torrematheus/ParahyBaja/Telemetria/telemetria_TesteAV/parahybaja2.jpeg

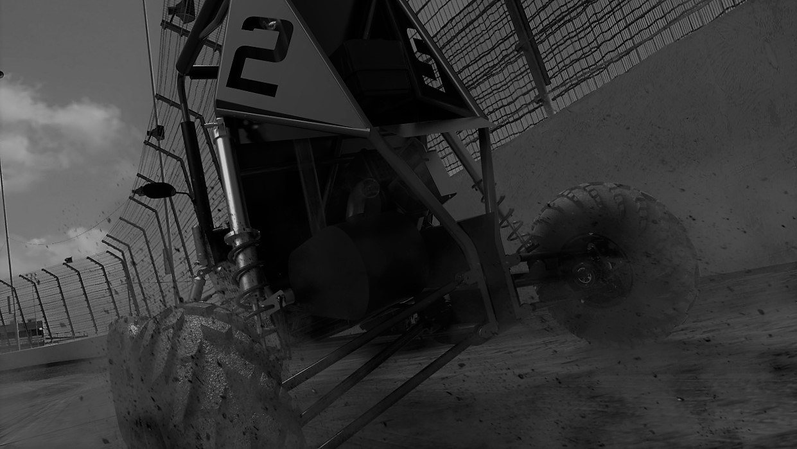
Telemetria/telemetria_TesteAV/parahybaja2.jpeg
