torrematheus/ParahyBaja/README.md

# ParahyBaja
 Hardware, Firmware e Documentação
