torrematheus/ParahyBaja/PB03 - Relatórios/RL01 - TCCs/TCC01 - Matheus Torres Rocha/TCC_Matheus_Torres_Rocha.pdf

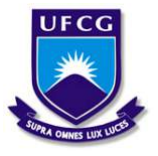
[picture p23: figure]

UNIVERSIDADE FEDERAL DE CAMPINA GRANDE

CENTRO DE ENGENHARIA ELETRICA E ´ | INFORMATICA ´
DEPARTAMENTO DE ENGENHARIA ELETRICA E ´ | INFORMATICA ´

## Sistema de telemetria para veículo off-road baseado em protocolo CAN

Matheus Torres Rocha

Campina Grande, PB

Julho de 2019

Matheus Torres Rocha

## Sistema de telemetria para veículo off-road baseado em protocolo CAN

Trabalho de Conclusao de Curso apresen- ˜

tado a Coordenaç ` | ao do Curso de Graduaç ˜ | aõ

em Engenharia Eletrica da Universidade Fe- ´

deral de Campina Grande, Campus Cam-

pina Grande, como parte dos requisitos ne-

cessarios para a obtenç ´ | ao do grau de Bacha- ˜

rel em Engenharia Eletrica. ´

Area de Concentraç ´ | ao: Instrumentaç ˜ | ao Eletr ˜ | onica, Sistemas Embarcados, Internet das Coisas e Sistemas ˆ
| | | Supervisorios. ´

Orientador: Jose S´ ergio da Rocha Neto ´

Campina Grande, PB

Julho de 2019

Matheus Torres Rocha

## Sistema de telemetria para veículo off-road baseado em protocolo CAN

Aprovado em | / | /

Prof. Jaidilson Jo da Silva ´

Universidade Federal de Campina Grande

Avaliador

Prof. Jose S´ ergio da Rocha Neto ´

Universidade Federal de Campina Grande

Orientador

Aos meus pais que nunca desistiram de mim.

## Agradecimentos

Agradeço primeiramente a Deus por ser o meu porto seguro e me dar forças para continuar cada dia em meio

a tantas dificuldades.

Aos meus pais Dayse e Antonio, ˆ | a minha irm ` | a Thays, ˜ | a minha av ` | o Vanilde, ´ | a minha namorada Klayne, pelo `
suporte e incentivo para eu nunca desistir do meu sonho. Tenho a certeza que nao teria chegado at ˜ | e aqui sem voc ´ | es. ˆ

Ao Prof. Pericles por ser o primeiro professor a acreditar no meu potencial e me dando a oportunidade de ´

estudar tudo que a universidade nao pode me oferecer, ao Prof. Rafael pela amizade, apoio e ajuda e ao amigo Charles ˜

por orientar em diversas situaçoes. Prof. Jos ˜ | e S´ ergio e Prof. Jaidilson por me dar a honra de t ´ | e-los como orientador e ˆ

avaliador, respectivamente, de trabalho de conclusao de curso, direcionando o caminho certo a ser seguido. ˜

A toda equipe ParahyBaja, em especial, Lucas, Douglas e Alberi pela oportunidade de realizar meu projeto `

de conclusao de curso no seu projeto de extens ˜ | ao. ˜

Aos amigos da universidade, em especial, Yago, Junior, Luquinhas e Ravi pela ajuda, incentivo, leites,

brincadeiras e trabalhos desenvolvidos durante todos os anos da minha graduaçao. ˜

Aos meus amigos da epoca do col ´ | egio, em especial, Rennan, Lucas, Giusepe, Gabriel, Maercio, Jorge, ´
Samuel, Emmanuel e Joao por sempre estarem ao meu lado nos momentos mais dif ˜ | | | | | íceis da minha caminhada, me

trazendo felicidade e suporte.

Por fim, agradeço a minha maior fonte de inspiraç ` | ao, minha av ˜ | o, mais conhecida como Dona Isabel a pessoa ´

mais iluminada que tive a honra de conhecer. Que mesmo nao estando presente, fisicamente, tenho certeza que esteve ˜

ao meu lado em todos os momentos da minha vida.

”A unica coisa que ningu ´ | em pode tomar de voc ´ | ê e o ´ conhecimento.”

## Resumo

O nível de tecnologia presente nos carros e um fator determinante quando se trata de conforto, praticidade ´

e desempenho. Assim, a necessidade da presença de telemetria em carros para competiçao Baja SAE ˜

BRASIL e indiscut ´ | ível. Este trabalho de conclusao de curso tem como objetivo o estudo para desenvolver, ˜

elaborar, testar e implementar um sistema de telemetria embarcado utilizando rede de comunicaçao via ˜

protocolo CAN, microcontroladores ST e Computaçao em Nuvem (Cloud Computing) de modo a analisar, ˜

salvar e tratar velocidade, rotaçao por minuto e n ˜ | ível de combustível do carro desenvolvido pela equipe

ParahyBaja.

Palavras chave: CAN, ParahyBaja, SAE BRASIL, Telemetria.

## Abstract

The level of technology present in cars is a determining factor when it comes to comfort, practicality

and performance. As a result, the necessity of telemetry in cars for competition Baja SAE BRAZIL is

unquestionable. The purpose of this paperwork is the study to develop, test and implement an embedded

telemetry system using CAN protocol, ST microcontrollers and Cloud Computing to analyze, save and

treat speed, rotation per minute and fuel level of the car developed by ParahyBaja team.

Keywords: CAN, ParahyBaha, SAE BRASIL, Telemetry.

# Lista de Figuras

1.1 Diagrama dos sensores e componentes para telemetria | | 2
2.1 Diagrama de blocos da conexao gen ˜ | erica de ECU | | 5 ´
2.2 Diagrama com as camadas utilizadas pelo protocolo CAN no modelo OSI | | 6
2.3 Topologia de barramento de rede CAN de acordo com a norma ISO 11898-2 | | 7
2.4 Nível de barramento de acordo com a norma ISO 11898-2 | | 8
2.5 Grafico da taxa de transmiss ´ | ao versus a distancia m ˜ | axima entre os n ´ | os | | 8 ´
2.6 Esquema de uma mensagem de dados | | 9
2.7 Esquema de uma mensagem de erro | | 10
2.8 Exemplo de arbitraçao na rede CAN | | 11 ˜
2.9 Diagrama de blocos de um no CAN | | 11 ´
2.10 Diagrama de blocos de um no CAN com a arquitetura Stand-Alone | | 12 ´
2.11 Diagrama de blocos de um no CAN com a arquitetura Integrada | | 12 ´
2.12 Diagrama de blocos de um no CAN com a arquitetura ´ | Single-Chip | | 13
2.13 Representaçao do funcionamento interno do sensor capacitivo | | 14 ˜
2.14 Exemplificaçao do campo eletromagn ˜ | etico de um sensor capacitivo | | 14 ´
2.15 Representaçao da estrutura interna do sensor indutivo | | 15 ˜
3.1 Representaçao esquem ˜ | atica da vista lateral do Baja ParahyBaja e locais propostos para ECU | | 16 ´

3.2 Circuito implementado na utilizaçao do ˜ | transiver MCP2551 | | 17
3.3 Representaçao esquem ˜ | atica da ECU1 | | 18 ´
3.4 Diagrama geral em maquina de estados da ECU1 | | 18
3.5 Fotografia do sensor indutivo LJ12A3-4-Z/BX | | 19
3.6 Circuito implementado na utilizaçao do sensor indutivo | | 19 ˜
3.7 Fotografia da bobina acoplada ao eixo do motor | | 20
3.8 Curvas da saída do sensor de rpm puro (2) e saída do sensor de rpm tratado (1) | | 21
3.9 Circuito implementado na utilizaçao do sensor de RPM | | 21 ˜
3.10 Fotografia do sensor capacitivo LJC18A3-B-Z/BY | | 22
3.11 Circuito implementado na utilizaçao do sensor de combust ˜ | ível | | 23
3.12 Representaçao esquem ˜ | atica da ECU2 | | 24 ´
3.13 Diagrama geral em maquina de estados da ECU2 | | 24
3.14 Representaçao esquem ˜ | atica da ECU3 | | 25 ´
3.15 Exemplo do painel frontal com LCD | | 25
3.16 Diagrama do recebimento de dados WEB | | 26
3.17 Escopo da mensagem JSON dentro do MongoDB | | 27
3.18 Fotografia do cabeçalho de dados unicos na plataforma ´ | WEB | | 28
3.19 Graficos de rpm em funç ´ | ao do tempo na plataforma ˜ | WEB | | 28
3.20 Graficos de velocidade em funç ´ | ao do tempo na plataforma ˜ | WEB | | 29
4.1 Fotografia do sistema implementado em protoboard | | 31
4.2 Fotografia da montagem do motor e sensores em bancada | | 32
4.3 Circuito simulador de RPM | | 33
4.4 Fotografia da placa final ECU1 | | 34

4.5 Fotografia das placas finais ECU3 e ECU2 | | 34
4.6 Fotografia do painel e sensores localizados no Baja | | 35
4.7 Plataforma WEB | | 36

# Lista de Abreviaturas e Siglas

CAN | - Controller Area Network
CI | - Circuito Integrado
ECU | - Electronic Controller Unit
GND | - Ground
GPS | - Global Position System
I2C | - Inter-Integrated Circuit
RPM | - Rotaçoes por Minuto ˜
SAE | - Sociedade de Engenheiros da Mobilidade

# Conteudo ´

1 Introduçaõ | 1
1.2 Organizaçao do texto | | 3 ˜
2 Revisao Bibliogr ˜ | afica ´ | 4
2.2 Competiçao Baja SAE BRASIL | | 5 ˜
2.3 Protocolo de Comunicaçao CAN | | 6 ˜
2.3.4 | No CAN | | 11 ´
3 Sistema Implementado | 16

3.4 Interface Humano-Maquina | | 26 ´
4 Implementaçaõ | 30
4.1 Implementaçao em Bancada | | 30 ˜
4.2 Confecçao das Placas | | 33 ˜
4.3 Implementaçao no Baja | | 34 ˜
5 Conclusoes ˜ | 37
6 Bibliografia | 38

# Capítulo 1

# Introduçaõ

No decorrer dos avanços tecnologicos, a eletr ´ | onica automotiva vem se tornando cada vez mais presente ˆ

no dia a dia dos indivíduos, tornando-se essencial para o conforto e a segurança do condutor, assim como para o

funcionamento e a performance de veículos.

Ao logo do desenvolvimento tecnologico dispositivos (sensores e atuadores) foram desenvolvidos para au- ´

xiliar na automaçao de m ˜ | aquinas, equipamentos e processos. Os sensores, mais especificamente, tem um papel in- ´
contestavel para o desenvolvimento automotivo. Possibilitando a verificaç ´ | ao e obtenç ˜ | ao de dados para processos, at ˜ | é
entao, indetect ˜ | aveis, como por exemplo velocidade, rotaç ´ | ao por minuto, entre outros [3]. ˜
Dada a importancia da eletr ˆ | onica automotiva, microcontroladores s ˆ | ao projetados e programados para serem ˜
embarcados em linhas automotivas chamados de unidade de controle eletronico ( ˆ | Electronic Control Unit - ECU). Suas
aplicaçoes s ˜ | ao as mais diversas poss ˜ | íveis, possuindo uma capacidade de processamento.

Exitem diversas ECU distribuídas pelo carro, por exemplo, no controle de nível de combustível por meio de

sensores resistivos, no controle de acionamento de airbag atraves de sensores de vibraç ´ | ao e no veloc ˜ | ímetro atraves de ´

sensores indutivos.

Entre as ECU tem-se entao a necessidade de uma comunicaç ˜ | ao precisa e segura, de forma a garantir con- ˜

fiabilidade e qualidade do sistema. Para essa necessidade, o sistema de barramento de dados CAN e utilizado como ´

padrao para a aplicaç ˜ | ao veicular [4 - 5], estando presente em todos os carros desenvolvidos atualmente. ˜

Entretanto, os veículos off-road Baja, mais precisamente os veículos utilizados para competiçao Baja SAE ˜

BRASIL, possuem uma deficiencia quando se trata de eletr ˆ | onica digital automotiva por se tratar de carros que necessi- ˆ
tam, a princípio, apenas de botoes de emerg ˜ | encia e luzes para seu funcionamento. ˆ
Em uma competiçao com foco em desenvolvimento tecnol ˜ | ogico, a implementaç ´ | ao de ECU se torna ne- ˜

cessaria, a fim de validar diversas funcionalidade do sistema, alcançar objetivos, conforto do piloto e melhorar perfor- ´

mance do veículo, tornando-se necessaria a criaç ´ | ao de um sistema de telemetria. ˜
Telemetria consiste na aquisiçao e envio de dados para um acumulador visando uma posterior an ˜ | alise [3]. ´
Possibilitando uma possível verificaçao de dados remotamente, por exemplo em pain ˜ | eis automotivos, ou nos dias atuais ´

a verificaçaõ online em meio a rede de internet.

## 1.1 Objetivo

Neste trabalho de conclusao de curso tem-se como objetivo projetar um sistema de eletr ˜ | onica embarcada ˆ
responsavel pela aquisiç ´ | ao, transmiss ˜ | ao e exibiç ˜ | ao de dados relevantes para a equipe e para o piloto em tempo real, ˜
tais como: rotaçao do motor, n ˜ | ível de combustível e velocidade. Uma possível soluçao do sistema est ˜ | a apresentada na ´

Figura 1.1:

Figura 1.1: Diagrama dos sensores e componentes para telemetria.

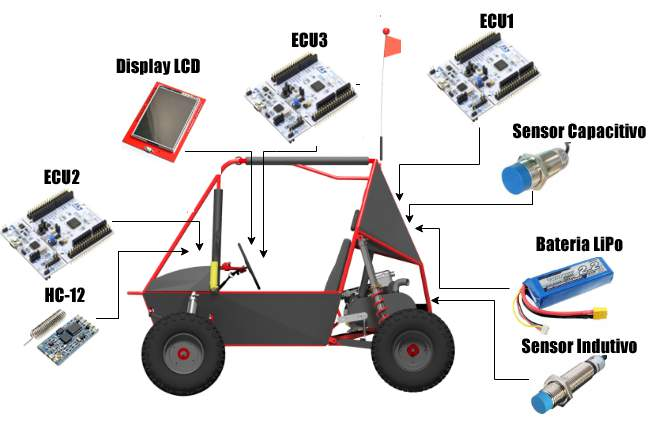
[picture p24: figure]

Fonte: Proprio Autor. ´

A alocaçao de sensores, seguida da aquisiç ˜ | ao dos dados para as ECU respons ˜ | aveis pela comunicaç ´ | ao com o ˜

painel e com o computador central, sera deste modo, um sistema de telemetria para o carro da equipe ParahyBaja. Os ´

objetivos específicos sao: ˜

- Selecionar tipos de sensores e ECU para aplicaçoes; ˜
- Desenvolver circuitos equivalentes para as aplicaçoes; ˜

- Desenvolver a programaçao do sistema; ˜
- Executar montagem do sistema em placa de ensaio;
- Planejar e executar testes para validaçao do sistema desenvolvido; ˜
- Desenvolver modulos definitivos para o projeto; ´
- Executar testes e implementaçao do sistema desenvolvido no ve ˜ | ículo.

## 1.2 Organizaçao do texto ˜

Neste capitulo foi apresentado a introduçao e os meus objetivos para esse trabalho de conclus ˜ | ao de curso. No ˜
capítulo 2 sera apresentada uma abordagem te ´ | orica aos t ´ | opicos relevantes do trabalho, para uma melhor compreens ´ | aõ

das atividades desenvolvidas. No capítulo 3, o sistema implementado. No capítulo 4, implementaçoes realizadas. Por ˜

fim, no capitulo 5 sao analisados os resultados com propostas para estudos futuros. ˜

# Capítulo 2

Revisao Bibliogr ˜ | afica ´

Neste capítulo apresenta-se os principais conceitos e fundamentos envolvidos no sistema proposto. Saõ

aqui descritos os conceitos de telemetria, competiçao Baja SAE BRASIL, protocolo de comunicaç ˜ | ao CAN e sensores ˜

utilizados.

## 2.1 Telemetria

A telemetria surgiu no ano de 1845 com o desenvolvimento do primeiro sistema de transmissao de dados ˜

entre o Winter Palace e o quartel da armada russa [3]. Em 1874 foi desenvolvida uma rede de sensores atmosfericos ´

em Mont Blanc, França, com transmissao de dados em tempo real para Paris. Mais tarde, em 1906 foram montadas ˜

series de estaç ´ | oes s ˜ | ísmicas na Russia, com transmiss ´ | ao de dados para o Pulkovo Observatory [3]. ˜
A telemetria automotiva e amplamente utilizada em ve ´ | ículos de uso comercial e maquinas agr ´ | ícolas [3].
O sistema de telemetria automotiva e respons ´ | avel pelo transporte e pelo armazenamento de dados do carro, como a ´
velocidade, a rotaçao do motor, o n ˜ | ível de combustível, a temperatura do motor, etc. Essa aquisiçao de dados ˜ | e realizada ´

por meio de sensores interligados, dos mais diversos tipos e maneiras.

A arquitetura interna do hardware composto nos veículos automotivos e distribu ´ | ída em ECU responsaveis, ´
em grande maioria, por uma aquisiçao de dados direcionado a um ˜ | unico sensor, atuador ou aç ´ | ao do ve ˜ | ículo. Seu nível

de complexidade e seu numero de ECU, disponíveis e conectadas entre si, e diretamente proporcional ao valor do ´

veículo [1].

As ECUs sao conectadas entre si atrav ˜ | es de um ´ | unico barramento para troca de informaç ´ | oes e concatenaç ˜ | aõ
do sistema como um todo. Assim, a diminuiçao do n ˜ | umero de cabos necess ´ | arios para conex ´ | ao das mesmas, maior ˜

robustez levando em consideraçao que erros em uma ECU podem n ˜ | ao afetar outras, podem ser observados como ˜
pontos positivos para a implementaç ` | ao de ECU, em contrapartida o custo, a exig ˜ | encia de uma implementaç ˆ | ao de ˜
protocolo de comunicaçao entre ECU s ˜ | ao pontos negativos do seu desenvolvimento. Um exemplo de conex ˜ | ao entre ˜

ECU e apresentada na Figura 2.1 ´

Figura 2.1: Diagrama de blocos da conexao gen ˜ erica de ECU. ´

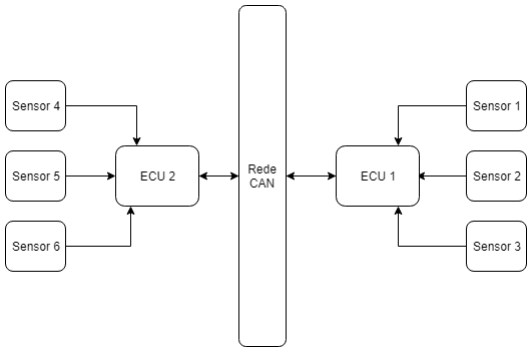
[picture p25: figure]

Fonte: Proprio Autor. ´

Diante dos avanços tecnologicos os bancos de dados, os tratamento de dados e as amostragem de resultados ´

estao sendo cada vez mais direcionado a sistemas em nuvem. Estes podendo ser acessados de qualquer parte do mundo, ˜

possuindo como pre-requisito apenas o acesso a internet. ´

## 2.2 Competiçao Baja SAE BRASIL ˜

O programa Baja SAE foi criado na Universidade da Carolina do Sul, Estados Unidos, sob a direçao do ˜

Dr. John F. Stevens, tendo sua primeira ediçao em 1976. O ano de 1991 marcou o in ˜ | | ício das atividades da SAE

BRASIL, que, em 1994, lançava o Programa Baja SAE BRASIL. No ano seguinte, em 1995, seria realizada a primeira

competiçao nacional, na pista Guido Caloi, bairro do Ibirapuera, cidade de S ˜ | | ao Paulo [10]. ˜

A competiçao SAE Baja Brasil tem por objetivo de conectar estudantes de diversas universidades para dis- ˜

putar uma competiçao que tem o intuito de projetar, desenvolver e criar carros tipo baja, capazes de superar diversas ˜

condiçoes, como por exemplo, lama, chuva, trepidaç ˜ | ao, etc. O ve ˜ | ículo deve ser capaz de acomodar um condutor desde

1,45 m de altura, com peso de 42 kg ate um condutor de 1,90 m de altura, com peso de 109 kg [10]. ´

## 2.3 Protocolo de Comunicaçao CAN ˜

Decorrente do alto numero de dispositivos de controles, sensores e atuadores presentes nos automoveis, ´

o numero de cabos para conexoes tornou-se um grande problema para a manutenç ˜ | ao, criaç ˜ | ao e detecç ˜ | ao de falhas ˜
muito complexas nos automoveis. Por essa raz ´ | ao, o protocolo de comunicaç ˜ | ao CAN ( ˜ | Controller Area Network) foi

desenvolvido pela empresa Robert Bosch GmbH na decada de 80 [5]. ´

Esse protocolo e definido pela resoluç ´ | ao ISO 11898 e tr ˜ | as consigo um modelo de referencia tipo OSI ( ´ | Open
System Interconnection), possuindo tres camadas: a camada f ˆ | ísica, a camada de enlace de dados e a camada de
aplicaçao. A camada de aplicaç ˜ | ao pode ser desenvolvida a crit ˜ | erio do desenvolvedor como por exemplo, o ´ | CANo-

pen [4]. Na Figura 2.2 apresenta-se as camadas que sao utilizadas dentro do modelo OSI pelo protocolo CAN. ˜

Figura 2.2: Diagrama com as camadas utilizadas pelo protocolo CAN no modelo OSI.

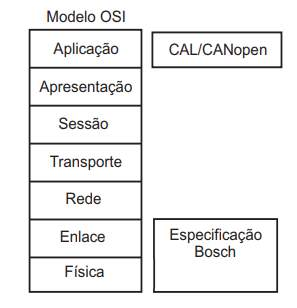
[picture p26: figure]

Fonte: Adaptado de [6].

Sua camada de enlace e física nao podem ser modificadas e s ˜ | ao diretamente implementadas no microchip de ˜
controle, ja a camada de aplicaç ´ | ao, como elencado anteriormente, fica a crit ˜ | erio do desenvolvedor. ´
O protocolo CAN tem como principais vantagens: a robustez, a reduçao de ru ˜ | ídos eletromagneticos e a ´
diminuiçao da complexidade de conex ˜ | oes entre sensores e atuadores [7]. Tamb ˜ | em, a sua especificaç ´ | aõ e dividida ´
em dois padroes para a vers ˜ | ao CAN 2.0, identificadas como 2.0A e 2.0B, possuindo diferença entre o tamanho do ˜
identificador de mensagem com 11 bits e 29 bits respectivamente. Entretanto, os dois padroes s ˜ | ao compat ˜ | íveis entre si

[4].

### 2.3.1 Camada Física

A transmissao de dados do protocolo CAN, ˜ | e composto por um par de fios trançados possuindo uma re- ´
sistencia de 120 Ohms nas pontas do seu barramento a fim de evitar reflex ˆ | oes do sinal e minimizar os efeitos eletro- ˜

magneticos. Pode-se observar a topologia de barramento da rede CAN na Figura 2.3. ´

Figura 2.3: Topologia de barramento de rede CAN de acordo com a norma ISO 11898-2.

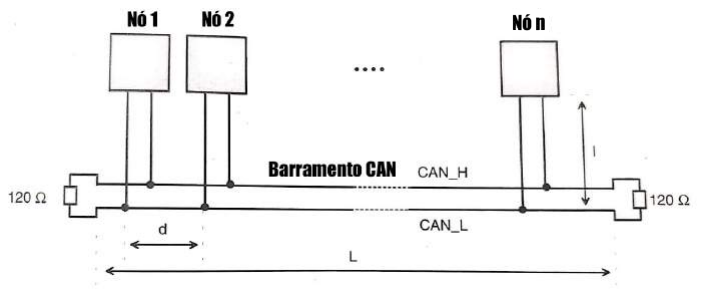
[picture p27: figure]

Fonte: Adaptado de [5].

Composto por dois fios, CAN H (CAN HIGH) e CAN L (CAN LOW), possui seu nível logico medido ´

decorrente da diferença de potencial entre os fios.

Vdif = VCAN H − VCAN L | (2.1)
Assim, quando seu nível logico possui um valor ´ | Vdif < 0, 5 e considerado recessivo e consequentemente ´
um valor 0, quando Vdif > 0, 9 e considerado dominante e possu ´ | í valor 1. O grafico da relaç ´ | ao entre a diferença de ˜

potencial dos fios pode ser vista na Figura 2.4

Figura 2.4: Nível de barramento de acordo com a norma ISO 11898-2.

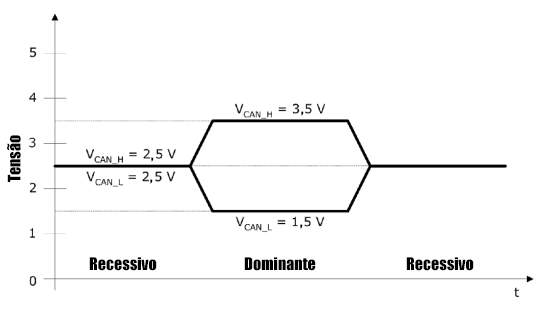
[picture p28: figure]

Fonte: Adaptado de [5].

A rede CAN apresenta limitaçoes para seu funcionamento, possuindo uma relaç ˜ | ao m ˜ | axima entre a taxa de ´
transferencia de bits versus a distancia m ˆ | axima permitida para o seu funcionamento (Figura 2.5). ´
Figura 2.5: Grafico da taxa de transmiss ´ | ao versus a distancia m ˜ | axima entre os n ´ | os. ´

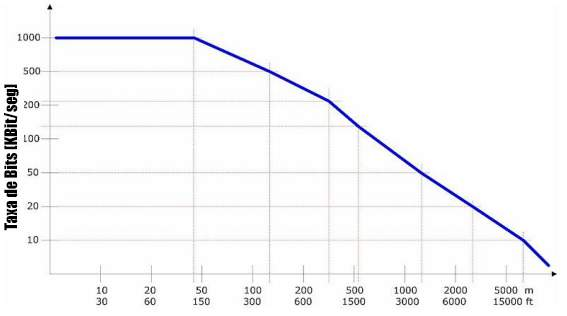
[picture p29: figure]

Fonte: Adaptado de [5].

### 2.3.2 Camada de Enlace

Os dados transmitidos atraves da rede CAN possuem quatro tipos distintos de mensagem: ´

Mensagem de Dados

A estrutura da mensagem de dados, apresentada na Figura 2.6, possui espaços especificamente alocados para

determinado dado da mensagem, sao eles: SOF ( ˜ | Start of Frame), arbitraçao ( ˜ | Arbitration Field), controle (Control

Field), campo de dados (Data Field), CRC (Cyclic Redundancy Check), ACK (Acknowledgement) e EOF (End of

Frame) [6].

Figura 2.6: Esquema de uma mensagem de dados.

Fonte: [6].

SOF - Responsavel por marcar o inicio da mensagem, apresentado por um ´ | unico bit dominante. ´
Arbitraçaõ - O campo de arbitraçao possui dois tamanhos, 11 ˜ | bits para a versao 2.0 A e 29 ˜ | bits para versao 2.0 ˜
B, ele e respons ´ | avel por enviar o n ´ | ível de prioridade da mensagem, seguindo a regra que quando menor for o
valor maior e o seu n ´ | ível de prioridade. Tambem, envia em seu ´ | ultimo bit ( ´ | Remote Transmit Request - RTR) a
responsabilidade de afirmar sua requisiçao de retransmiss ˜ | ao de dados. ˜
Controle - Seu primeiro bit (IDE) e respons ´ | avel por identificar a vers ´ | ao da rede CAN e, em seus ˜ | bits restantes, possui

a tarefa de informar a quantidade de bytes que serao transmitidas na mensagem. ˜

Campo de dados - Reservado para transmissao da mensagem, possuindo um tamanho m ˜ | aximo de 8 ´ | bytes.
CRC - Responsavel por conter o ´ | checksum da mensagem para uma verificaçao de poss ˜ | íveis erros na transmissao de ˜

dados.

ACK - E respons ´ | avel por reconhecer uma mensagem sem erro, o transmissor verifica atrav ´ | es da resposta do receptor, ´
caso essa resposta esteja correta e enviada bit dominante e caso contrario ´ | e enviado um bit recessivo. ´

EOF - Responsavel por finalizar a mensagem. ´

Mensagem de requisiçao remota de dados ˜

Utilizado para solicitar dados, a estrutura da mensagem de requisiçao remota de dados possui os mesmos ˜

campos da mensagem de dados, entretanto nao possui o campo de dados. ˜

Mensagem de erro

A estrutura da mensagem de erro pode ser verificada na Figura 2.7.

Figura 2.7: Esquema de uma mensagem de erro.

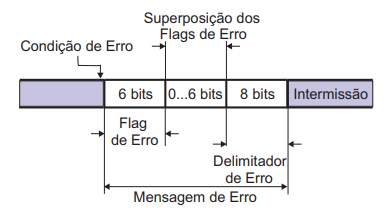
[picture p30: figure]

Fonte: [6].

Os primeiros 6 bits da mensagem correspondem à flag de erro que possui dois estados: o ativo, que identifica

erro em nos ativos e o passivo, que identifica erro em n ´ | os passivos. O delimitador de ´ | flags de erro e composto por oito ´

bits recessivos.

Mensagem de sobrecarga

A mensagem de sobrecarga e igual ´ | a estrutura utilizada para a mensagem de erro, mas ` | e utilizada para realizar ´

atrasos maiores na transmissao de pacotes. ˜

### 2.3.3 Controle de Acesso ao Meio

Para controlar o acesso ao meio a CAN utiliza o metodo CSMA/CA ( ´ | Carrier-Sense Multiple Acess with
Collision Avoidance), o metodo garante que durante a fase de arbitraç ´ | ao, ou seja, durante a disputa pelo acesso ao ˜
barramento, apenas o no que tiver a mensagem com maior prioridade permanecer ´ | a transmitindo a mensagem ap ´ | os o ´

final do campo de arbitraçao [4]. ˜

O metodo funciona da seguinte maneira: quando o n ´ | o envia o ´ | bit dominante, ele continua no processo, e
envia o proximo ´ | bit da sua mensagem de arbitraçao, caso um n ˜ | o envie um ´ | bit recessivo enquanto outro no envia o ´ | bit

dominante esse no ganhar ´ | a a disputa para leitura de dados. Por exemplo, pode ser observado no bit 5 (N ´ | o 2) e no bit 2 ´
(No 1) do identificador, na Figura 2.8, vencendo o n ´ | o 3, visto que ele cont ´ | em a mensagem com maior prioridade [6]. ´

Figura 2.8: Exemplo de arbitraçao na rede CAN. ˜

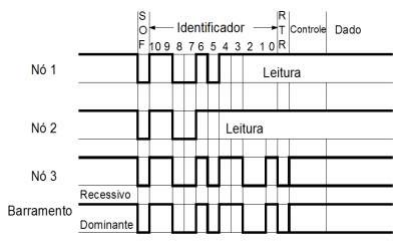
[picture p31: figure]

Fonte: [6].

### 2.3.4 No CAN ´

Para implementar um no CAN (Figura 2.9) s ´ | ao necess ˜ | arios tr ´ | es componentes b ˆ | asicos: um ´ | transceiver, um

controlador CAN e um microcontrolador [6]. Cada componente possui uma açao primordial para o funcionamento ˜

da rede CAN, o microcontrolador e respons ´ | avel por configurar os perif ´ | ericos (sensores e atuadores) instalados em ´
seu sistema, o controlador CAN e respons ´ | avel por disponibilizar as funç ´ | oes para uma poss ˜ | ível implementaçao e o ˜
transceiver e respons ´ | avel por traduzir os dados que chegam atrav ´ | es do barramento CAN. ´

Figura 2.9: Diagrama de blocos de um no CAN. ´

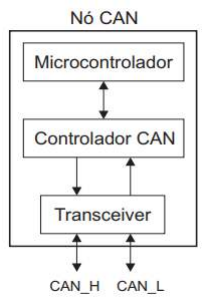
[picture p32: figure]

Fonte: [6].

Existem diversos tipos de microcontroladores no mercado, ao que se trata de protocolo CAN, eles podem ser

classificados em tres tipos de microcontroladores [7]: ˆ

- Stand-Alone
Na arquitetura Stand-Alone (Figura 2.10) e separada do controlador CAN e do ´ | transceiver, necessitando acoplar

um controlador e um transceiver em sua implementaçao. ˜

Figura 2.10: Diagrama de blocos de um no CAN com a arquitetura Stand-Alone. ´

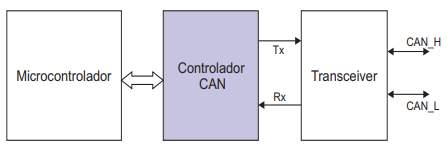
[picture p33: figure]

Fonte: [6].

- Integrada;

Na arquitetura integrada (Figura 2.11) temos o microcontrolador e o controlador integrados em um unico chip e ´

apenas o transceiver separado da implementaçao. ˜

Figura 2.11: Diagrama de blocos de um no CAN com a arquitetura Integrada. ´


Fonte: [6].

- Single-Chip;

Na arquitetura Single-Chip (Figura 2.12) temos o microcontrolador, controlador e transceiver unidos em um

unico chip. ´

Figura 2.12: Diagrama de blocos de um no CAN com a arquitetura ´ | Single-Chip.

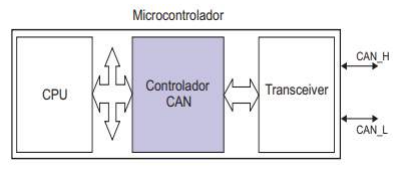
[picture p34: figure]

Fonte: [6].

## 2.4 Sensores

Existem diversos tipos de sensores, como por exemplo os sensores capacitivos e os sensores indutivos.

### 2.4.1 Sensor Capacitivo

O sensor capacitivo (Figura 2.13) em seu princípio operacional toma como parametro a capacit ˆ | ancia. Uma ˆ

chave de proximidade capacitiva funciona com um circuito oscilante de alta frequencia que cria um campo eletro- ˆ

magnetico na superf ´ | ície ativa do sensor por meio de um capacitor. Quando uma substancia solida ou fluida se apro- ´
xima deste campo ocorre um desequilíbrio de capacitancia e leva a uma variaç ˆ | ao da amplificaç ˜ | ao no circuito oscilante. ˜
Se esta amplificaçao exceder um valor limite, um sinal de comutaç ˜ | aõ e gerado. Uma exemplificaç ´ | ao de suas ondas ˜

eletromagneticas podem ser vistas na Figura 2.14 [8]. ´

Figura 2.13: Representaçao do funcionamento interno do sensor capacitivo. ˜

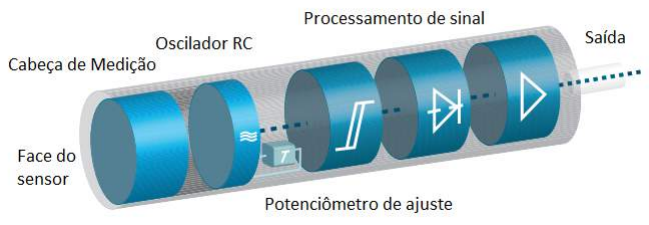
[picture p35: figure]

Fonte: Adaptado de [8].

Figura 2.14: Exemplificaçao do campo eletromagn ˜ | etico de um sensor capacitivo. ´

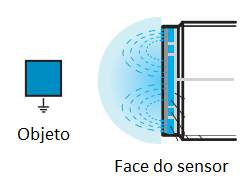
[picture p36: figure]

Fonte: Adaptado de [8].

O sensor pode ser pre-fabricado em diversas situaç ´ | ao de funcionamento, l ˜ | ogica positiva (PNP) ou l ´ | ogica ´
negativa (NPN), ou seja, no caso PNP, o sensor indicara um n ´ | ível logico alto ao detectar uma variaç ´ | ao no seu campo, ˜
ja no caso NPN, o sensor indicar ´ | a um n ´ | ível logico baixo para as mesmas condiç ´ | oes. ˜

### 2.4.2 Sensor Indutivo

Assim como o sensor capacitivo, o funcionamento do sensor indutivo (Figura 2.15) em seu princípio opera-

cional toma como parametro a indut ˆ | ancia. ˆ
Seu funcionamento consiste em um íma de barra, com um pino ferromagn ˜ | etico, sustentando uma bobina de ´

induçao com dois terminais e quando uma engrenagem de anel ferromagn ˜ | etico (ou um rotor de projeto semelhante) ´
passa por este sensor, gera uma tensao na bobina, tens ˜ | ao esta diretamente proporcional a variaç ˜ | ao peri ˜ | odica do fluxo ´

magnetico [9]. ´

Esse tipo de sensor, possui o mesmo funcionamento de logica do sensor capacitivo, ou seja, ele pode ser ´

fabricado como PNP ou como NPN.

Figura 2.15: Representaçao da estrutura interna do sensor indutivo. ˜

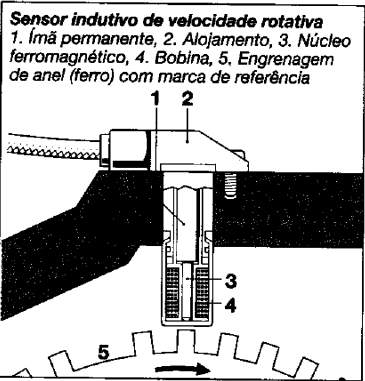
[picture p37: figure]

Fonte: [9].

# Capítulo 3

# Sistema Implementado

Primeiramente, foi feito um estudo sobre sistemas em veículos automotivos, baseado em carros confecciona-

dos por grandes empresas, optou-se por um sistema em rede CAN, contendo tres ECU interligadas entre si, possuindo ˆ

tres tipos de sensores: sensor de velocidade, sensor de rotaç ˆ | oes por minuto e sensor de combust ˜ | ível. Tambem, o sistema ´

(Figura 3.1) possui o diferencial de estar diretamente interligado ao um sistema online e um banco de dados.

Figura 3.1: Representaçao esquem ˜ | atica da vista lateral do Baja ParahyBaja e locais propostos para ECU. ´

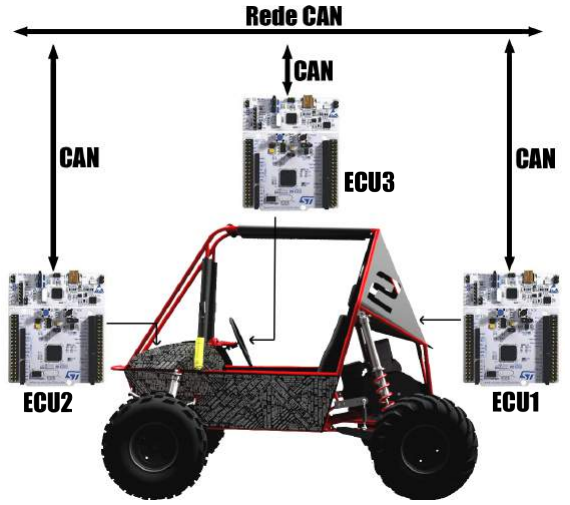
[picture p38: figure]

Fonte: Proprio Autor. ´

As ECUs utilizadas tem como base o microcontrolador NUCLEO-F303RE, fabricado pela empresa STMicro-

electronics responsavel, tamb ´ | em, por fabricar sistemas para utilizaç ´ | ao em ve ˜ | ículos automotivos por grande empresas

como: BMW, Mecedes, etc. Entretanto, o microcontrolador utilizado para esse projeto, trata-se de um microcontrola-

dor com arquitetura integrada, necessitando, assim, de um transiver.

O transiver utilizado e o MCP2551, segundo MCP2551 foi montado o circuito (Figura 3.2). ´

Figura 3.2: Circuito implementado na utilizaçao do ˜ transiver MCP2551.

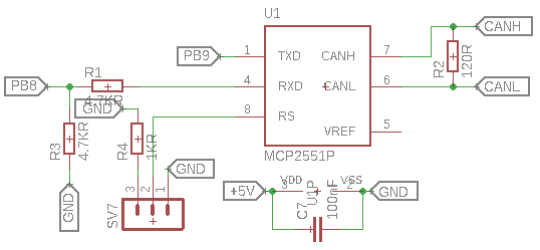
[picture p39: figure]

Fonte: Proprio Autor. ´

Pode-se verificar que o circuito trata as mensagens CAN H e CAN L com o objetivo de enviar dados atraves´

de seu RX e TX para o controlador interligados com os pinos PB8 e PB9, respectivamente, do microcontrolador.

## 3.1 ECU1

A ECU1 (Figura 3.3), e respons ´ | avel por obter e trata as informaç ´ | oes dos sensores implementados no carro e ˜

repassar essas informaçoes ao longo do barramento CAN. ˜

Figura 3.3: Representaçao esquem ˜ | atica da ECU1. ´

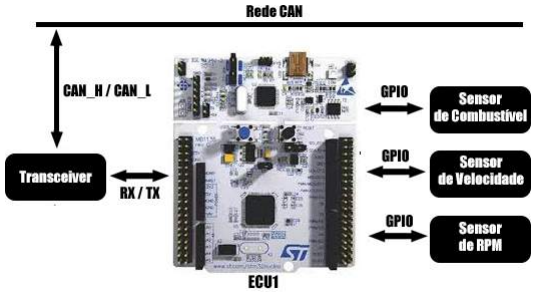
[picture p40: figure]

Fonte: Proprio Autor. ´

Ao ser chamada a interrupçao temporal implementada no microcontrolador, toda a informaç ˜ | ao adquirida dos ˜
sensores sao tratadas em inteiros de oito ˜ | bits e enviada. O funcionamento geral da ECU1 pode ser vista decorrente do

diagrama em maquina de estados da Figura 3.4.

Figura 3.4: Diagrama geral em maquina de estados da ECU1.

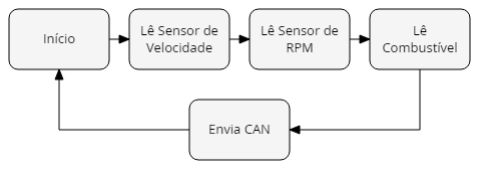
[picture p41: figure]

Fonte: Proprio Autor. ´

### 3.1.1 Sensor de Velocidade

Para o sensor de velocidade, utilizou-se o sensor indutivo (Figura 3.5 - LJ12A3-4-Z/BX) decorrente de seu

baixo custo de mercado, da sua precisao e do seu grau de proteç ˜ | ao ser IP65. Segundo ETT, o sensor possui polaridade ˜
NPN, com um nível de tensao de operaç ˜ | ao entre 6 e 36 volts em tens ˜ | ao continua e uma corrente de sa ˜ | ída de 300 mA

[12].

Figura 3.5: Fotografia do sensor indutivo LJ12A3-4-Z/BX.

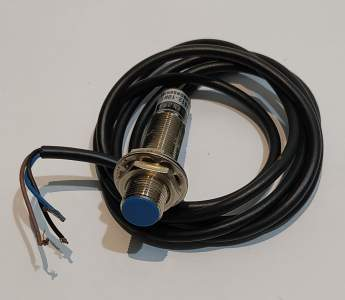
[picture p42: figure]

Fonte: Proprio Autor. ´

Esse sinal eletrico ´ | e recebido e tratado utilizando um circuito eletr ´ | onico (Figura 3.6). ˆ

Figura 3.6: Circuito implementado na utilizaçao do sensor indutivo. ˜


Fonte: Proprio Autor. ´

Onde a entrada VEL e respons ´ | avel por receber o sinal puro do sensor indutivo e o pino PA10 ´ | e respons ´ | avel ´

por enviar o sinal tratado para o microcontrolador. O circuito referente ao tratamento de dados do sensor de velocidade

e composto por um amplificador operacional implementado com a funç ´ | ao de ˜ | buffer com o intuito de isolar o sensor
[11]. Tambem, alimentando o mesmo com uma tens ´ | ao de +3,3 V e terra ˜ | e poss ´ | ível regular a seu nível logico para 3,3 ´
V, o nível logico m ´ | aximo exigido pelo microcontrolador. ´
O sensor e posicionado bem pr ´ | oximo ao eixo de rotaç ´ | ao do carro, similar a Figura 2.15, ao longo do eixo s ˜ | aõ
anexados quatro ímas igualmente espaçados a fim de aumentar a precis ˜ | ao do sensor. ˜

Em seu algoritmo de implementaçao, ˜ | a cada volta do pneu o microcontrolador receber ` | a quatro pulsos em ´
sua entrada digital, entrada na qual esta programada com uma interrupç ´ | ao externa, incrementando valor unit ˜ | ario a um ´
contador especifico. Ao longo de um período de tempo, ja pr ´ | e-determinado, esse contador ´ | e verificado se seu valor ´
e divis ´ | ível por quatro, caso nao seja, recebe um decremento at ˜ | e ser divis ´ | ível por quatro e, entao, ˜ | e utilizado para o ´

calculo da velocidade. Logo em seguida, o contador zerado, retomando, assim, o fluxo de contagem. ´

O veículo automotivo possui uma velocidade variada ao longo de sua trajetoria, variado sua aceleraç ´ | ao. ˜
Entretanto, utilizando-se da equaçao do movimento retil ˜ | íneo uniformemente variado (MRUV), sabendo-se que a
interrupçao temporal ˜ | e muito r ´ | apida e a aceleraç ´ | ao no intervalo de tempo para o motor do carro ˜ | e irris ´ | oria, pode- ´

mos considerar seu movimento como um movimento retilíneo e uniforme (MRU) no pequeno intervalo de tempo e

aplicar a equaçao MRU a fim de se obter a velocidade [11]. ˜

Vm = 3, 6

Pv
Pe
Tv
Cp | (3.1)
Em sua equaçao, ˜ | a velocidade ( ` | Vm), primeiramente, e calculada com o contador referente a interrupç ´ | aõ
digital do sensor de velocidade (Pv) dividido pela quantidade de ímas no eixo ( ˜ | Pe), posteriormente o resultado é
dividido por o tempo da interrupçao temporal em segundos ( ˜ | Tv), multiplicado por comprimento do pneu (Cp) e,

finalmente, multiplicado por 3,6 para transformar de metros por segundo em quilometros por hora. ˆ

### 3.1.2 Sensor de RPM

O sensor de RPM utilizado ao sistema, trata-se de uma bobina acoplada ao eixo interno do motor (Figura

3.7).

Figura 3.7: Fotografia da bobina acoplada ao eixo do motor.

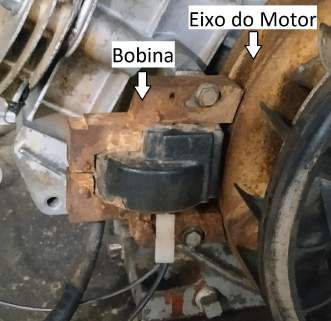
[picture p43: figure]

Fonte: Proprio Autor. ´

O eixo possui um íma em seu eixo, ao passar pr ˜ | oximo a bobina, gera um campo eletromagn ´ | etico fazendo a ´
bobina conduzir eletricidade e projeta um espectro (Figura 3.8) cujo a frequ ` | encia ˆ | e modificada ao depender, especifi- ´

camente, da velocidade do eixo, ou seja, velocidade do motor.

Figura 3.8: Curvas da saída do sensor de rpm puro (2) e saída do sensor de rpm tratado (1).

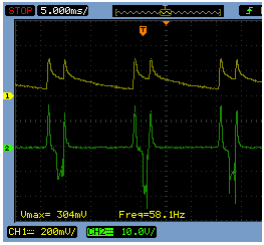
[picture p44: figure]

Fonte: Proprio Autor. ´

A curva e tratado atrav ´ | es de um circuito el ´ | etrico (Figura 3.9) para tratar o sinal para uma leitura adequada do ´

microcontrolador.

Figura 3.9: Circuito implementado na utilizaçao do sensor de RPM. ˜

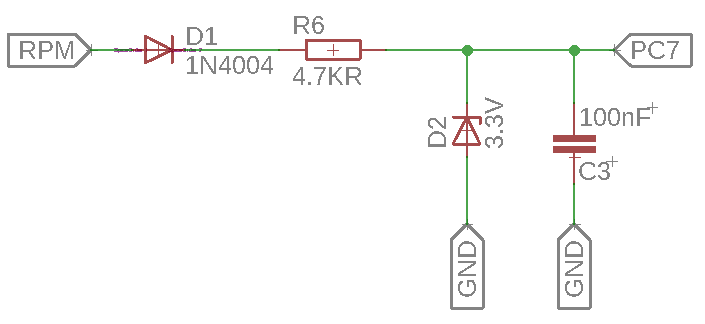
[picture p45: figure]

Fonte: Proprio Autor. ´

Primeiramente, seu sinal e retificado atrav ´ | es do diodo (D1), logo ap ´ | os´ e regulado a tens ´ | ao a um n ˜ | ível de
aproximadamente 3,3 V decorrente do diodo zener (D2). Tambem, para evitar ru ´ | ídos, foi-se necessario implementar ´

um capacitor (C3).

O seu algoritmo, funciona com interrupçao externa da variaç ˜ | ao de mudança do seu n ˜ | ível logico para uma ´

possível decida e subida, como visto na Figura 3.8, tera quatro pulsos para cada volta do eixo do motor mudando ´

apenas a sua equaçao e a cada interrupç ˜ | ao um contador ˜ | e incrementado. Ap ´ | os isso, o RPM ´ | e calculado, por meio da ´
equaçao (3.2), toda vez que a interrupç ˜ | ao temporizada ˜ | e chamada. ´

RPM =

60
Pv
Trpm
Prpm | (3.2)
Onde a rotaçao do motor (RPM) ˜ | e calculado mediante do valor de pulsos por volta ( ´ | Pv), tempo da interrupçaõ

(Trpm) e contador (Prpm).

### 3.1.3 Sensor de Combustível

A mediçao de combust ˜ | ível e baseada em sensores capacitivos (Figura 3.10 - LJC18A3-B-Z/BY), mais espe- ´

cificamente, dois sensores capacitivos. O sensor foi escolhido visando, segundo HWE, o mesmo tipo de especificaçaõ

do sensor indutivo implementado ao sensor de velocidade, sao elas: grau de proteç ˜ | ao ser IP65, precis ˜ | ao e custo de ˜

mercado [13]. Entretanto, diferentemente do sensor indutivo, o sensor capacitivo implementado ao sistema possui

polaridade PNP, nível de tensao continua de operaç ˜ | ao entre 6 a 36 V. ˜

Figura 3.10: Fotografia do sensor capacitivo LJC18A3-B-Z/BY.

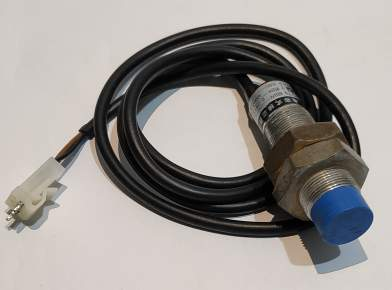
[picture p46: figure]

Fonte: Proprio Autor. ´

O circuito eletronico ˆ | e condicionado atrav ´ | es de um circuito da Figura 3.11. No qual, a entrada do sensor ´
(COMB1) e condicionada atrav ´ | es de um diodo zener, assim como o sensor de RPM, o seu n ´ | ível logico ´ | e retificado para ´

se adaptar ao microcontrolador.

Figura 3.11: Circuito implementado na utilizaçao do sensor de combust ˜ | ível.

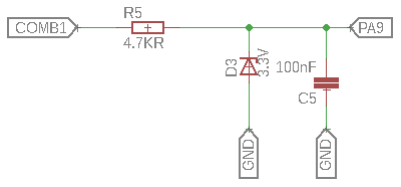
[picture p47: figure]

Fonte: Proprio Autor. ´

Sua logica ´ | e mais simplificada, quando comparada ao sensores anteriores, a cada interrupç ´ | ao temporal a ˜
propria funç ´ | ao verifica se o sensor est ˜ | a ativado ou n ´ | ao. O l ˜ | ogica possui tr ´ | es estados poss ˆ | íveis.
- Primeiro caso: Dois sensores estao ativados, a l ˜ | ogica identifica que o tanque de combust ´ | ível esta cheio. ´
- Segundo caso: O sensor inferior esta ativado e o sensor superior desativado, identifica que o tanque de com- ´
bustível esta com metade do combust ´ | ível maximo. ´
- Terceiro caso: Ambos os sensores estao desativos, a l ˜ | ogica identifica que o tanque est ´ | a na reserva e precisa ser ´

abastecido urgentemente.

## 3.2 ECU2

A ECU2 (Figura 3.12), e respons ´ | avel por receber e tratar os dados enviados via rede CAN pela ECU1, ´
tambem, ´ | e respons ´ | avel por enviar-los, atrav ´ | es de um m ´ | odulo de radio frequ ´ | encia (HC-11) para o computador a fim de ˆ

salvar os dados no banco de dados.

Figura 3.12: Representaçao esquem ˜ | atica da ECU2. ´

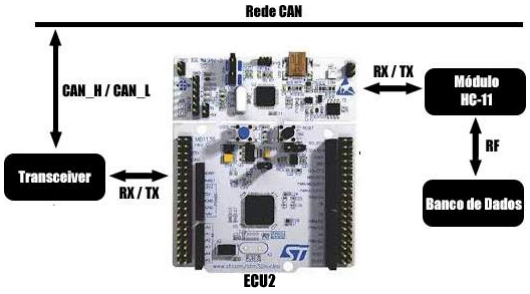
[picture p48: figure]

Fonte: Proprio Autor. ´

A transmissao de r ˜ | adio frequ ´ | encia utiliza-se do protocolo de comunicaç ˆ | ao RS-232 [16], dispon ˜ | ível no
modulo implementado. Sua pre-configuraç ´ | aõ e feita para existir uma sincronia e uma transmiss ´ | ao de dados perfeita ˜

em seu par.

A implementaçao da ECU2 ˜ | e feita da seguinte maneira: Os dados que chegam atrav ´ | es da rede CAN s ´ | aõ
verificados e analisados se estao corretos, caso estejam, os dados s ˜ | ao enviados via comunicaç ˜ | ao RS-232 para o m ˜ | odulo, ´

que por sua vez, envia os dados para o seu respectivo par conectado ao um banco de dados [2]. Seu diagrama de

maquina de estados geral pode ser visto na Figura 3.13.

Figura 3.13: Diagrama geral em maquina de estados da ECU2.

Fonte: Proprio Autor. ´

## 3.3 ECU3

A ECU3 (Figura 3.14), e respons ´ | avel, tamb ´ | em, por receber e tratar os dados enviados via rede CAN e exibi- ´

los em um display de cristal líquido (LCD 4x20 [14]).

Figura 3.14: Representaçao esquem ˜ | atica da ECU3. ´

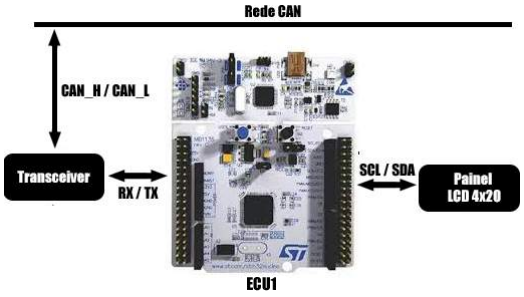
[picture p49: figure]

Fonte: Proprio Autor. ´

A transmissao de dados para o ˜ | display utiliza-se do protocolo de comunicaçao I2C [15], assim, faz-se ne- ˜
cessaria apenas dois barramentos (SCL e SDA) para a sua transmiss ´ | ao. ˜

Seu algoritmo de implementaçao funciona, primeiramente, verificando os dados recebidos, caso os dados ˜

recebidos estejam corretos, os mesmos sao enviados para o LCD j ˜ | a pre-configurado para aloc ´ | a-los nos seus devidos ´

lugares. Esse painel (Figura 3.15) e instalado na parte frontal do volante, dando visibilidade ao motorista. ´

Figura 3.15: Exemplo do painel frontal com LCD.

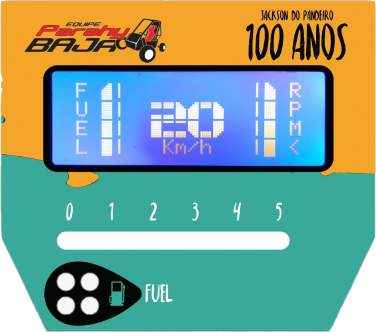
[picture p50: figure]

Fonte: Proprio Autor. ´

## 3.4 Interface Humano-Maquina ´

O painel foi desenvolvido em uma plataforma web, pensando justamente na praticidade de acesso e tambem´

pela grande compatibilidade, por funcionar em qualquer dispositivo que navegue na internet.

O funcionamento de tudo se da pelo recebimento de dados que s ´ | ao enviados pelo microcontrolador por meio ˜

do modulo HC-11, visto que estes dados recebidos sao tratados e armazenados em banco de dados, para que assim ˜

sejam exibidos na plataforma Web para amostrar dados como velocidade, RPM, nível de combustível, entre outras

analises necess ´ | arias. ´

### 3.4.1 Recebimento de Dados

Os dados sao recebidos por meio da utilizaç ˜ | ao do m ˜ | odulo HC-11, em que a leitura serial ´ | e feita por meio de ´
codigo desenvolvido em linguagem ´ | python, visto que a mesma e capaz de receber os dados com a mesma velocidade ´
de transmissao ( ˜ | baundrate) com que os dados sao enviados, criando assim, uma leitura em tempo real dos dados que ˜

devem ser aferidos e tratados. O diagrama do recebimento de dados esta na Figura 3.16. ´

Figura 3.16: Diagrama do recebimento de dados WEB.

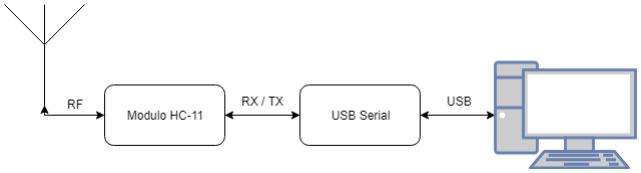
[picture p51: figure]

Fonte: Proprio Autor. ´

### 3.4.2 Tratamento de Dados

Os dados sao recebidos, formando dez conjuntos de 8 bits para valor aferido nos sensores, estes valores, por ˜

sua vez, sao convertidos separadamente em bin ˜ | arios e concatenados ap ´ | os a convers ´ | ao, gerando assim, dois bin ˜ | ario de ´
32 bits e dois binarios de 8 bits correspondendo aos valores de velocidade, RPM e combust ´ | | | | ível respectivamente. Uma
vez que formado o binario de 32 bits, este valor ´ | e convertido para decimal, afim de retornar ao valor inicial aferido ´

pelos sensores.

### 3.4.3 Armazenamento em Banco de Dados

Para banco de dados, foi escolhido o MongoDB um dos bancos nao relacional ( ˜ | Not Only SQL - NOSQL).

O mesmo se trata de um banco de dados orientado a documentos no formato JSON, ou seja, diferente de um banco

de dados relacional, ele nao possui como restriç ˜ | ao a necessidade de ter as tabelas e colunas criadas previamente, ˜
aumentando assim, a sua escalabilidade e permitindo que um documento represente toda a informaçao necess ˜ | aria, com ´

todos os dados que o sistema necessita, no formato de um JSON [17].

Assim como em um JSON utilizado em comunicaçoes HTTP entre aplicaç ˜ | oes, no documento do ˜ | MongoDB
podem existir valores simples, como numeros, ´ | strings e datas, assim como tambem podem existir listas de valores e ´
listas de objetos. Os documentos sao agrupados em coleç ˜ | ao, um conjunto de coleç ˜ | oes formam um banco de dados. O ˜

MongoDB permite que seu banco de dados seja replicado para outros servidores, aumentando assim a disponibilidade

de suas informaçoes, sendo esse recurso conhecido por ˜ | replica set. Dessa forma, cada servidor tera uma c ´ | opia dos ´

dados.

Para o projeto, para o escopo da palavra JSON a ser utilizada no sistema fazemos o uso dos seguintes dados: `

RPM, velocidade, combustível, tempo e o índice de cada informaçao ( ˜ index), conforme a Figura 3.17.

Figura 3.17: Escopo da mensagem JSON dentro do MongoDB.

Fonte: Proprio Autor. ´

### 3.4.4 Plataforma WEB

Pensando em deixar mais pratica a visualizaç ´ | ao das estat ˜ | ísticas e valores em tempo real do veículo, foi
desenvolvido uma plataforma WEB para que fosse compatível com uma grande quantidade de usuarios e que n ´ | aõ
possuísse grandes limitaçoes. Deste modo, foi desenvolvida uma aplicaç ˜ | ao que, junto dos procedimentos citados ˜
anteriormente, e capaz de amostrar todos os dados recebidos e ter, tamb ´ | em, uma an ´ | alise ao longo do tempo sobre o ´

desempenho do veículo capaz de cronometrar os tempos de voltas que o baja percorreu.

Toda a parte de parte de retaguarda (back-end) foi construída em linguagem de programaçaõ python por meio

da plataforma Django, pelo fato de que todo o recebimento de dados e tido em ´ | Python, conseguimos fazer o uso de

Chart.js, JQuery, HTML5 e Bootstrap com a interaçao dos dados aferidos inicialmente pelos sensores instalados no ˜

veículo.

O ciclo de dados da plataforma e dado, primeiramente, por receber os dados via HC-11 e os transmite pelo ´

modulo USB-Serial, ap ´ | os isso, realiza uma leitura serial e trata os dados em ´ | Python, os dados sao armazenados em ˜
banco de dados nao relacional que por sua vez ˜ | e respons ´ | avel por apresentar os dados que ser ´ | ao amostrados com gr ˜ | aficos ´
e valores unicos na plataforma ´ | WEB.
A plataforma WEB pode ser dividida em tres cabeçalhos: Os dados ˆ | unicos (Figura 3.18), os dados de rpm ´
em funçao do tempo (Figura 3.19) e os dados de velocidade em funç ˜ | ao do tempo (Figura 3.20). ˜
Figura 3.18: Fotografia do cabeçalho de dados unicos na plataforma ´ | WEB.

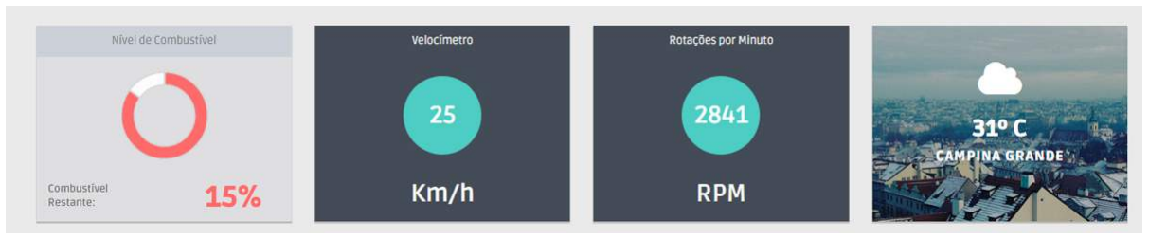
[picture p52: figure]

Fonte: Proprio Autor. ´

Em sua primeira parte sao apresentados dados ˜ | unicos, contendo a porcentagem de combust ´ | ível restante no

tanque, a velocidade em tempo real, o RPM em tempo real e o clima em tempo real.

Figura 3.19: Graficos de rpm em funç ´ | ao do tempo na plataforma ˜ | WEB.

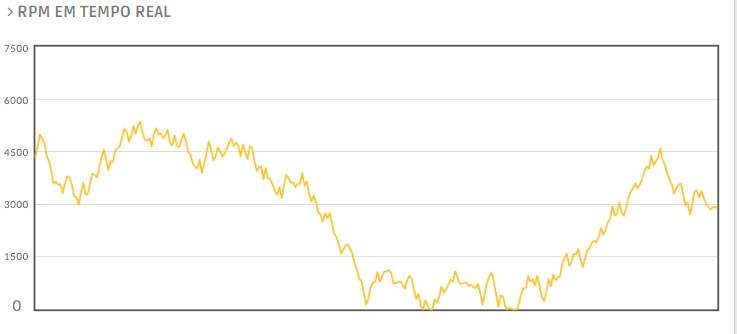
[picture p53: figure]

Fonte: Proprio Autor. ´

A segunda parte e respons ´ | avel por amostrar o gr ´ | afico de RPM versus o seu tempo no momento que foi ´

aferido, sendo atualizado a cada período de tempo que novos dados sao recebidos e tratados. ˜

Figura 3.20: Graficos de velocidade em funç ´ | ao do tempo na plataforma ˜ | WEB.

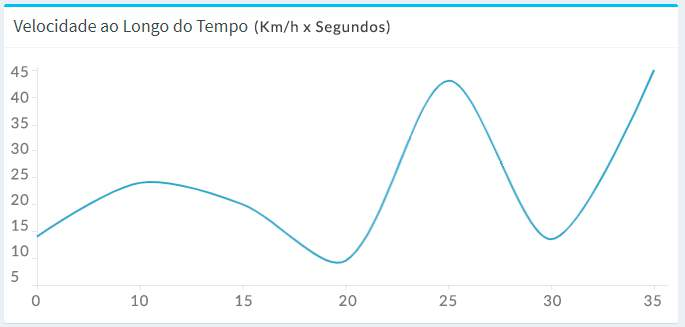
[picture p54: figure]

Fonte: Proprio Autor. ´

A terceira, ultima, parte ´ | e composta por um gr ´ | afico que ´ | e respons ´ | avel por plotar os valores de velocidade em ´
funçao do tempo, sendo atualizado, tamb ˜ | em, a cada per ´ | íodo de tempo que novos dados sao recebidos e tratados. ˜

# Capítulo 4

# Implementaçaõ

Para implementaçao do sistema, etapas foram seguidas. Primeiramente foi realizada a implementaç ˜ | ao em ˜

bancada, depois foram desenvolvidas as placas e por fim foi feita a implementaçao no baja. ˜

## 4.1 Implementaçao em Bancada ˜

Primeiramente, o codigo em c para o funcionamento do sistema foi escrito e o circuito referente ao sistema ´

foi montado em protoboard. O resultado da montagem pode ser visto na Figura 4.1.

Figura 4.1: Fotografia do sistema implementado em protoboard.

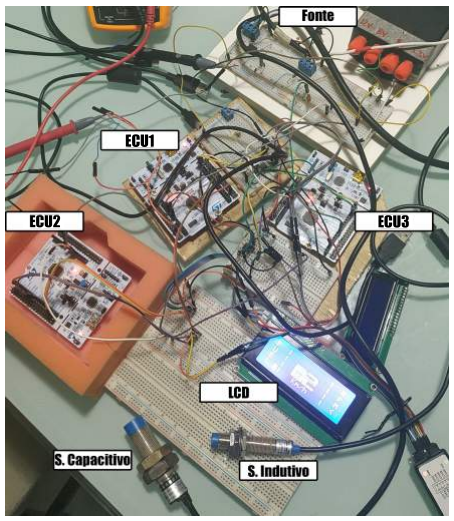
[picture p55: figure]

Fonte: Proprio Autor. ´

Onde temos sensor indutivo, sensor capacitivo, ECU1, ECU2, ECU3, todo o circuito eletronico e uma fonte ˆ

de bancada para ligar todo o sistema.

Apos a montagem, foi-se para a fase de uma poss ´ | ível validaçao do sistema, para isso foi montado um o motor ˜

em bancada e instalado os sensores em seu corpo. Fixou-se o sensor de velocidade ao motor, o sensor de combustível

ao tanque de combustível e anexou um conector a saída da bobina interno do motor a fim de se obter o sinal do RPM.

A Figura 4.2 apresenta a montagem referenciada.

Figura 4.2: Fotografia da montagem do motor e sensores em bancada.

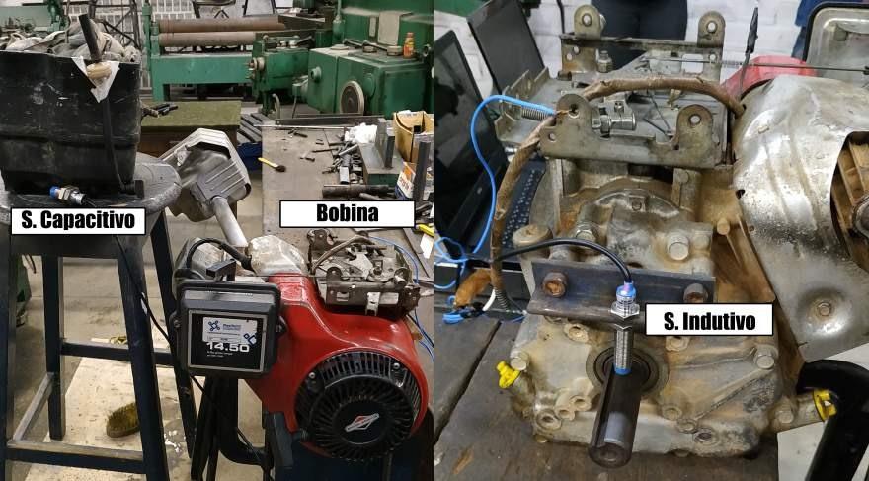
[picture p56: figure]

Fonte: Proprio Autor. ´

Para fins de verificar seu funcionamento, foi conectado aos barramentos da rede CAN um analisador logico ´

e seguindo o manual do motor foi possível verificar que o sistema estava em pleno funcionamento.

Alem disso, foi projetado um circuito simulador (Figura 4.3) para simular o mesmo espectro de sa ´ | ída da

bobina do sensor de RPM. Sabendo que o sinal tratado e digitalizado da tensao da vela se trata de dois pulsos agrupados. ˜

Para a digitalizaçao se tomou por par ˜ | ametro 2,5V que ˆ | e um valor frequente ao microcontrolador utilizado (STM 32). ´

Figura 4.3: Circuito simulador de RPM.

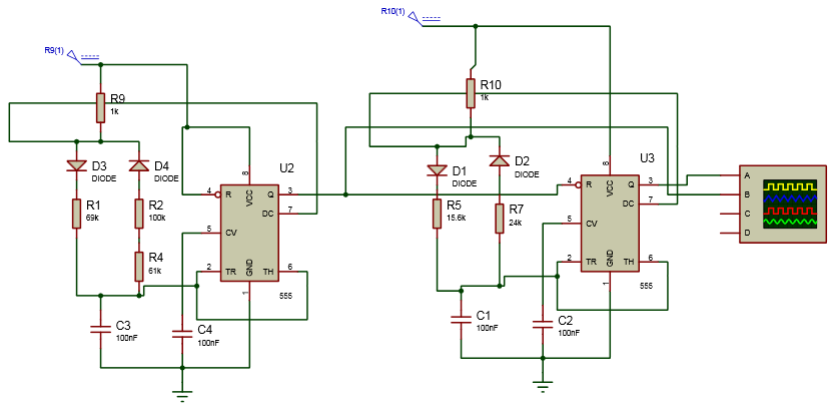
[picture p57: figure]

Fonte: Proprio Autor. ´

Foram utilizados dois CIs com um formato de associaçao em s ˜ | erie no qual o que se encontra no in ´ | ício tem

sua saída conectada ao pino reset do seguinte e a temporizaçaõ e feita de modo a o primeiro CI se manter ativo durante ´

o tempo de ocorrerem os dois pulsos e o segundo temporizado para gerar uma onda quadrada com dois períodos no

tempo ativo do primeiro.

O circuito simulador foi montado e em funçao da imprecis ˜ | ao dos componentes utilizados o circuito montado ˜

gerou um sinal condizente com uma rotaçao de 2886 RPM. Ao conecta-lo ao sistema, foi verificado, mais uma vez, a ˜

eficiencia do mesmo. ˆ

## 4.2 Confecçao das Placas ˜

Ao realizar os ensaios em bancada, o proximo passo foi a confecç ´ | ao das placas em um circuito impresso. ˜

Para isso, todo o circuito foi projetado e desenvolvido no software Eagle, sendo possível fazer toda a placa em seus

mínimos detalhes.

Para a a placa de circuito impresso referente a ECU1, alem de todo o circuito j ´ | a apresentado, foi introduzido ´

componentes para regular a tensao e medidas de segurança segundo o regulamento SAE BRASIL. A MCU1 impressa ˜

e com todos os componentes soldados em seus respectivos lugares, apresenta-se na Figura 4.4

Figura 4.4: Fotografia da placa final ECU1.

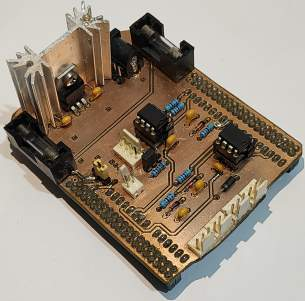
[picture p58: figure]

Fonte: Proprio Autor. ´

Ja a placas confeccionadas referente ´ | a ECU3 e ECU2 s ` | ao apresentadas na Figura 4.5. ˜

Figura 4.5: Fotografia das placas finais ECU3 e ECU2.

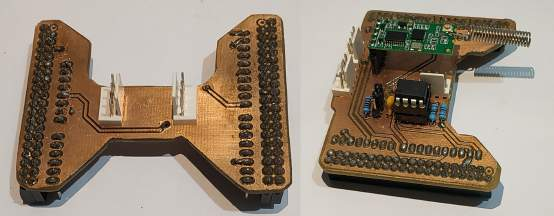
[picture p59: figure]

Fonte: Proprio Autor. ´

A ECU3, o circuito referente ao transceiver esta localizada na parte inferior da placa, estando em sua parte ´

superior apenas as conexoes com a rede CAN e o ˜ | diplay. A ECU2, todo o circuito ja apresentado no capitulo anterior ´
esta localizado na parte superior da placa juntamente com o m ´ | odulo de radio frequ ´ | encia (HC-11). ˆ

## 4.3 Implementaçao no Baja ˜

O painel e todas ECU foram devidamente instaladas no carro, e entao realizado o experimento no Baja. ˜

Tambem, foram instalados os sensores, assim como nos testes de bancada, em seus respectivos lugares. A localizaç ´ | aõ

do sistema na estrutura do baja apresenta-se na Figura 4.6

Figura 4.6: Fotografia do painel e sensores localizados no Baja.

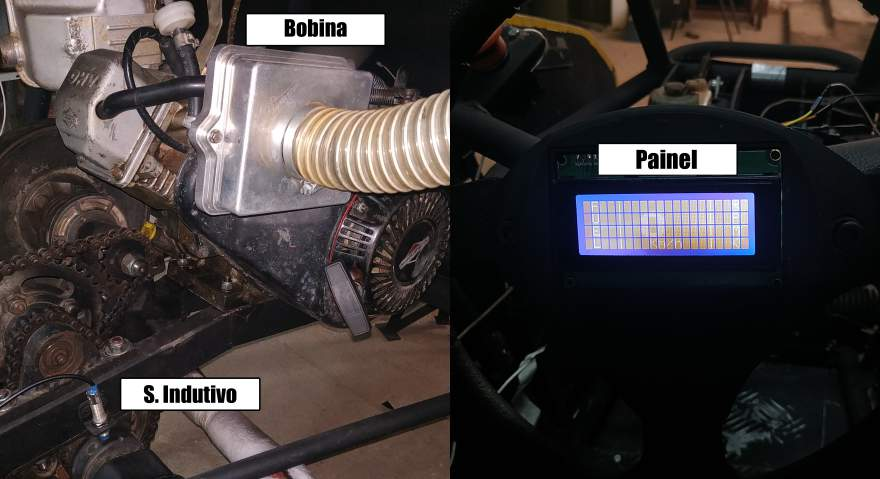
[picture p60: figure]

Fonte: Proprio Autor. ´

Atraves da transmiss ´ | ao em tempo real dos dados via o m ˜ | odulo HC-11 tornou-se poss ´ | ível analisar os dados

via plataforma web (Figura 4.7).

Figura 4.7: Plataforma WEB.

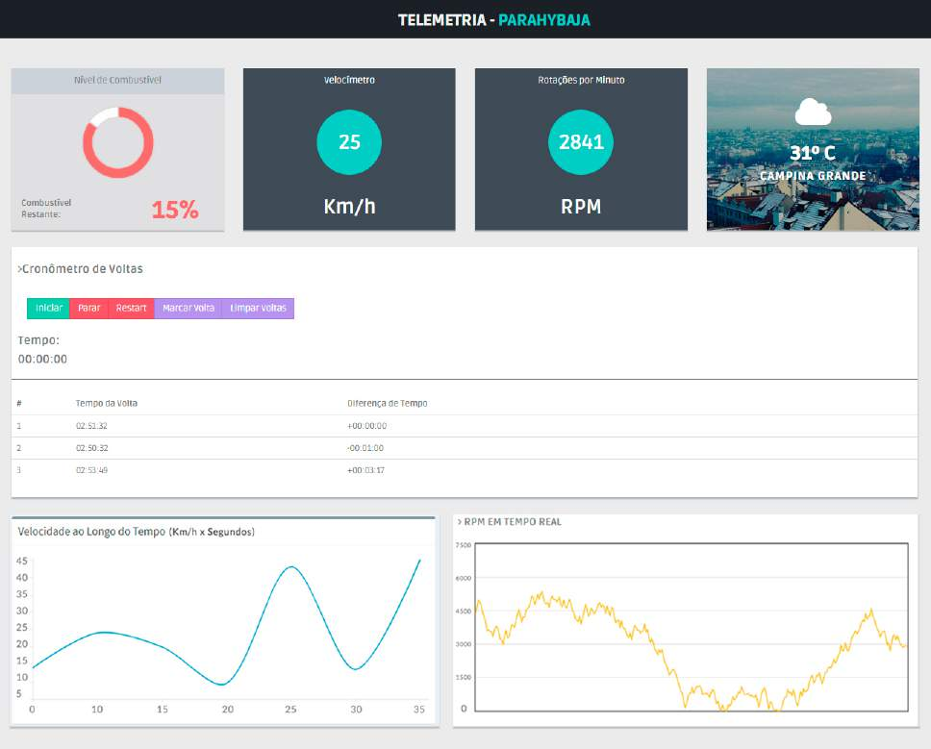
[picture p61: figure]

Fonte: Proprio Autor. ´

Assim como foi detalhado na seçao anterior, a interface homem-m ˜ | aquina apresentou os valores adequados ´
para as mediçoes no exato momento da implementaç ˜ | ao. ˜

# Capítulo 5

# Conclusoes ˜

Com o sistema de rede CAN implementado, o projeto se tornou robusto, confiavel e eficaz. Sensores de ´

velocidade e de rpm, anteriormente ineficientes devido a implementaçao err ˜ onea, foram validados e implementados de ˆ

maneira apropriada e a quantidade de fios devido a rede CAN diminuiu.

Considerando, tambem, requisitos e restriç ´ | oes do regulamento da competiç ˜ | ao objetivos foram traçados de ˜
maneira objetiva e clara. Portanto, o objetivo deste projeto de conclusao de curso n ˜ | aõ e aprofundar um conhecimento ´

especifico mas sim aplicar conceitos e conhecimentos pre-existentes. ´

O desenvolvimento possibilita uma visao mais clara da construç ˜ | ao do projeto ao longo do tempo que se foi ˜

projetado e desenvolvido. Conclui-se, portanto, que o real objetivo do projeto foi alcançado.

Por fim, devido a equipe possuir uma constante rotatividade de membros efetivos, o registro do projeto

possibilita que o trabalho seja continuado para uma futura otimizaçao do mesmo. Assim, ˜ | e sugerido como trabalhos ´
futuros a introduçao de mais sensores, como: GPS, sensor de ˜ | oleo, sensores de temperatura e sensor de vibraç ´ | ao dos ˜
quais nao foram poss ˜ | íveis adicionar ao trabalho de conclusao de curso, devido ao pequeno tempo de desenvolvimento ˜

do mesmo.

# Capítulo 6

# Bibliografia

[1] ALMEIDA, G. A. de O Protocolo CAN Bus nas Aplicaçoes Off-Road: Uma An ˜ | alise Comparativa entre os Padr ´ | oes ˜

Existentes.’ Society of Automotive Engineers, 2001.

[2] WANG, K. C. ‘Embedded and Real-Time Operating Systems’, Springer, 2017.
[3] TEXEIRA, F. C. R.; OLIVEIRA, M. C. de; HELENO, A. L. ”Telemetria Automotiva Via Internet Movel,” Revista ´

Ciencia e Tecnologia, vol. 16, 2013. ˆ

[4] PFEIFFER, O.; AYRE, A.; KEYDEL, C. ”Embedded Networking with CAN and CANopen”, RTC Books, 2003.
[5] ETSCHBERGER, K. ”Controller Area Network: Basics, Protocols, Chips and Applications”, IXXAT Automation

GmbH, 2001.

[6] SA, J. da S. ´ | ”Projeto e Analise de um Sistema de Aquisiç ´ | ao de Dados Distribu ˜ | ído para Aplicaçoes em Tempo ˜

Real”, Tese (Mestrado) - Universidade Federal de Campina Grande, 2007.

[7] ESRO, M.; BASARI, A. A.;, S, S. K.; A. SADHIQIN, A. M. I.; SYARIFF, Z. ”Controller Area Network (CAN)

Application in Security System ”, World Academy of Science, Engineering and Technology 35, 2009.

[8] BAUMER, ”Capacitive sensors: Versatile, contactless, durable”, Edition 2012/2013, 2012.
[9] BOSCH, R. ”Manual de Tecnologia Automotiva”, Editora Edgard Blucher, Traduçao da 25 ˜
| | | a
ediçao alem ˜ | a, 2004. ˜
[10] SAE BRASIL ”Regulamento Baja SAE Brasil”, 2019.
[11] SEDRA, A. S., SMITH, K. C. ”Microeletronica”, Editora Edgard Blucher, Quarta Ediç ˆ | ao, Makron Books, 2000. ˜
[12] ETT CO., LTD. ”Datasheet: | LJ12A3-4-Z/BX”, Disponível em: | http://www.ett.co.th/ productSensor/

LJ12A3-4-Z BX/LJ12A3-4-Z B\%20SENSOR.pdf Acesso: 18/06/2019.

[13] HWE | ”Datasheet: | LJC18A3-B-Z/BY”, | Disponível: | http:// files.microjpm.webnode.com/

200003722-858c88684b/Condutive\%20Proximity\%20Switch\%20Series.pdf Acesso: 18/06/2019.

[14] SYSTRONIX ”Datasheet: LCD 4x20”, Disponível: http://www.systronix.com/ access/ Systronix 20x4 lcd brief

data.pdf Acesso: 20/06/2019.

[15] PARET, D.; FENGER, C.”The I2c Bus: From Theory to Practice” John Wiley Sons, 1997
[16] AXELSON, J. ”Serial Port Complete: COM Ports, USB Virtual COM Ports, and Ports for Embedded Systems”

Lakeview Research, 2nd, 2007

[17] CROCKFORD, D. ”The application/json Media Type for JavaScript Object Notation (JSON)” The Internet So-

ciety, 2006.
