torrematheus/ParahyBaja/Telemetria/telemetria_TesteAV/limc.png

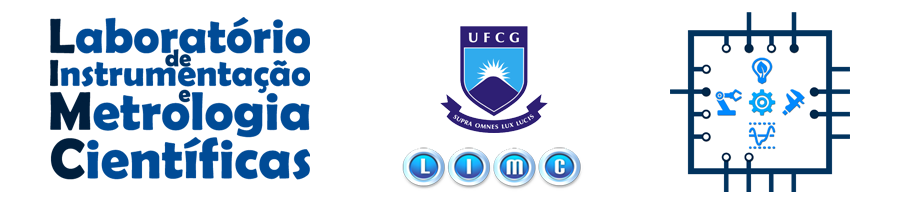
Telemetria/telemetria_TesteAV/limc.png
