torrematheus/ParahyBaja/Telemetria/telemetria_TesteAV/parahybaja.png

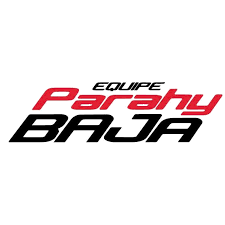
Telemetria/telemetria_TesteAV/parahybaja.png
