torrematheus/ParahyBaja/PB01 - Hardware/HW02 - Placa de teste do Extensometro/Extensometro_Nomes.pdf

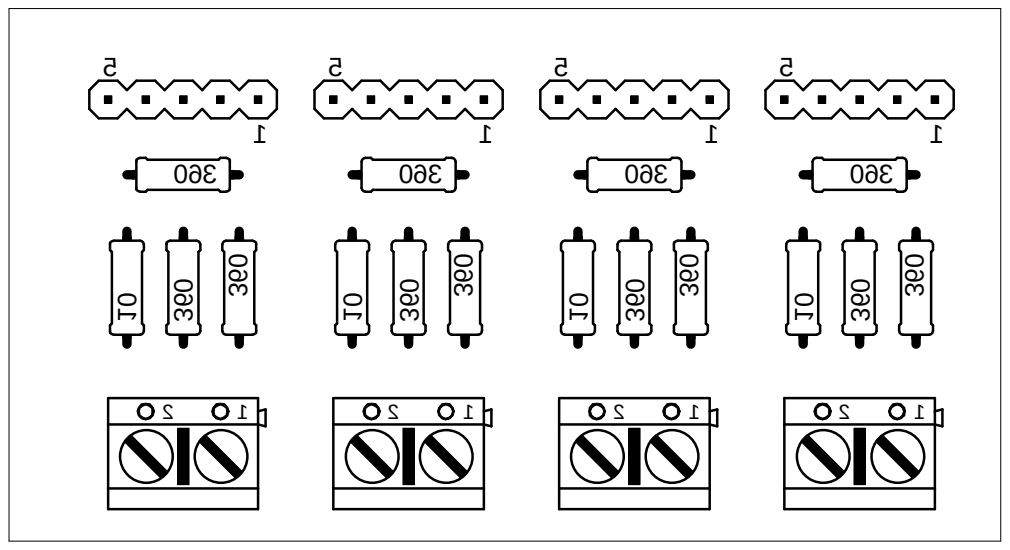
[picture p64: page 1]
