torrematheus/ParahyBaja/(list of files, drawings)

Other design files:
PB01 - Hardware/HW06 - Placa de teste AV 2.0/Simulation/simulation_teste_av.pdsprj
