torrematheus/ParahyBaja/PB01 - Hardware/HW08 - Placa ECU2 NAC20/ecu2.brd

## EAGLE design PB01 - Hardware/HW08 - Placa ECU2 NAC20/ecu2.brd (2020-02-21)

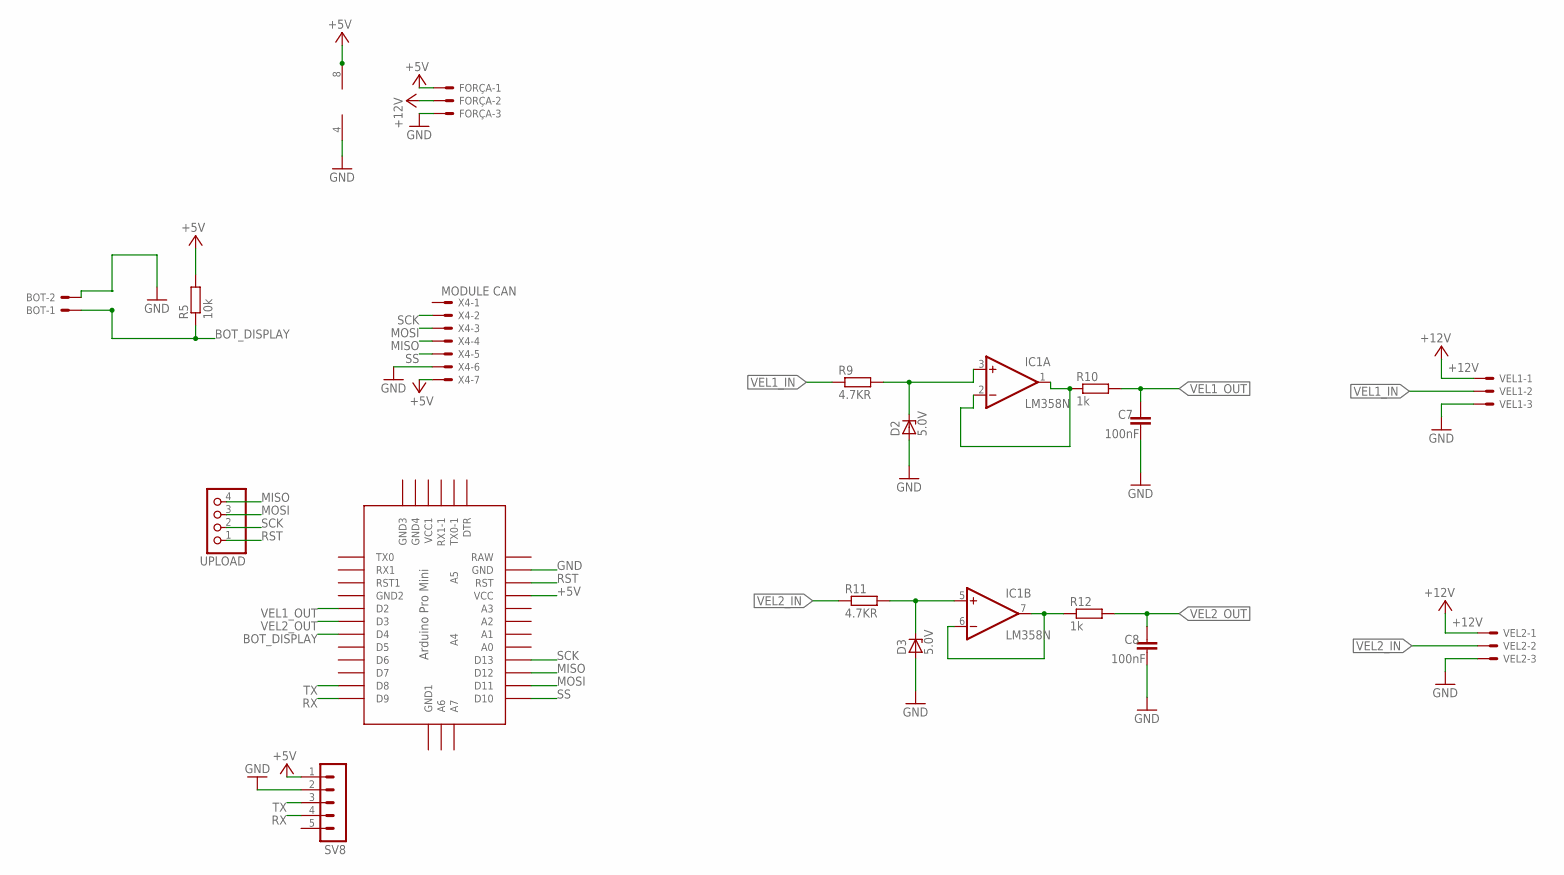
[picture p65: schematic ecu2.sch]

Parts:
BOT: RPM; 22-23-2021
C7, C8: 100nF; C5B2.5
D2, D3: 5.0V; DO34Z7
FORÇA: FORÇA; 22-23-2031
IC1: LM358N; DIL08
R5: 10k; 0207/7
R9, R11: 4.7KR; 0207/7
R10, R12: 1k; 0207/7
SV8: MA05-1
U$1: ABK-PRO-MINI
UPLOAD: PINHD-1X4; 1X04
VEL1: COMB 1; 22-23-2031
VEL2: COMB 2; 22-23-2031
X4: MODULE CAN; 22-23-2071

Connections:
+5V: FORÇA.1, IC1.8 (V+), R5.2, SV8.1, U$1.VCC, X4.7; also elsewhere on the board
+12V: FORÇA.2, VEL1.1, VEL2.1
BOT_DISPLAY: BOT.1, R5.1, U$1.D4
GND: BOT.2, C7.1, C8.1, D2.A, D3.A, FORÇA.3, IC1.4 (V-), SV8.2, U$1.GND, VEL1.3, VEL2.3, X4.6; also elsewhere on the board
LEDS: U$1.D6; also elsewhere on the board
MISO: U$1.D12, UPLOAD.4, X4.4
MOSI: U$1.D11, UPLOAD.3, X4.3
unnamed: D2.C, IC1.3 (+IN), R9.2
unnamed: IC1.1 (OUT), IC1.2 (-IN), R10.1
unnamed: D3.C, IC1.5 (+IN), R11.2
unnamed: IC1.6 (-IN), IC1.7 (OUT), R12.1
RST: U$1.RST, UPLOAD.1
RX: SV8.4, U$1.D9
SCK: U$1.D13, UPLOAD.2, X4.2
SS: U$1.D10, X4.5
TX: SV8.3, U$1.D8
VEL1_IN: R9.1, VEL1.2
VEL1_OUT: C7.2, R10.2, U$1.D2
VEL2_IN: R11.1, VEL2.2
VEL2_OUT: C8.2, R12.2, U$1.D3

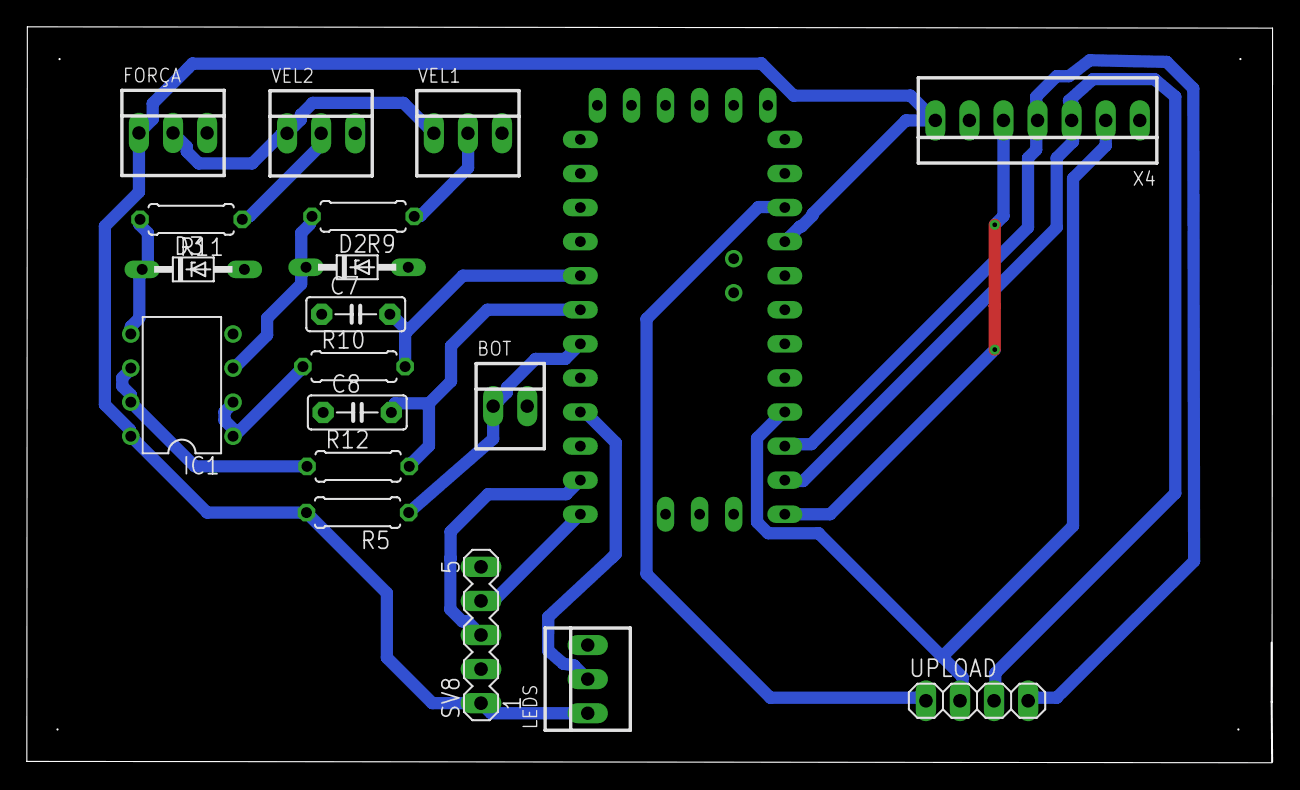
[picture p66: board ecu2.brd from above]

Board: 2 copper layers, 92.9 x 54.9 mm, 19 parts (0 on the bottom side), 20 nets.

Other parts of the board:
LEDS: FORÇA; 22-23-2031

Their connections:
+5V: LEDS.1; also elsewhere on the board
GND: LEDS.3; also elsewhere on the board
LEDS: LEDS.2; also elsewhere on the board
