torrematheus/ParahyBaja/PB01 - Hardware/HW07 - Placa ECU1 NAC20/ecu1.brd

## EAGLE design PB01 - Hardware/HW07 - Placa ECU1 NAC20/ecu1.brd (2020-02-20)

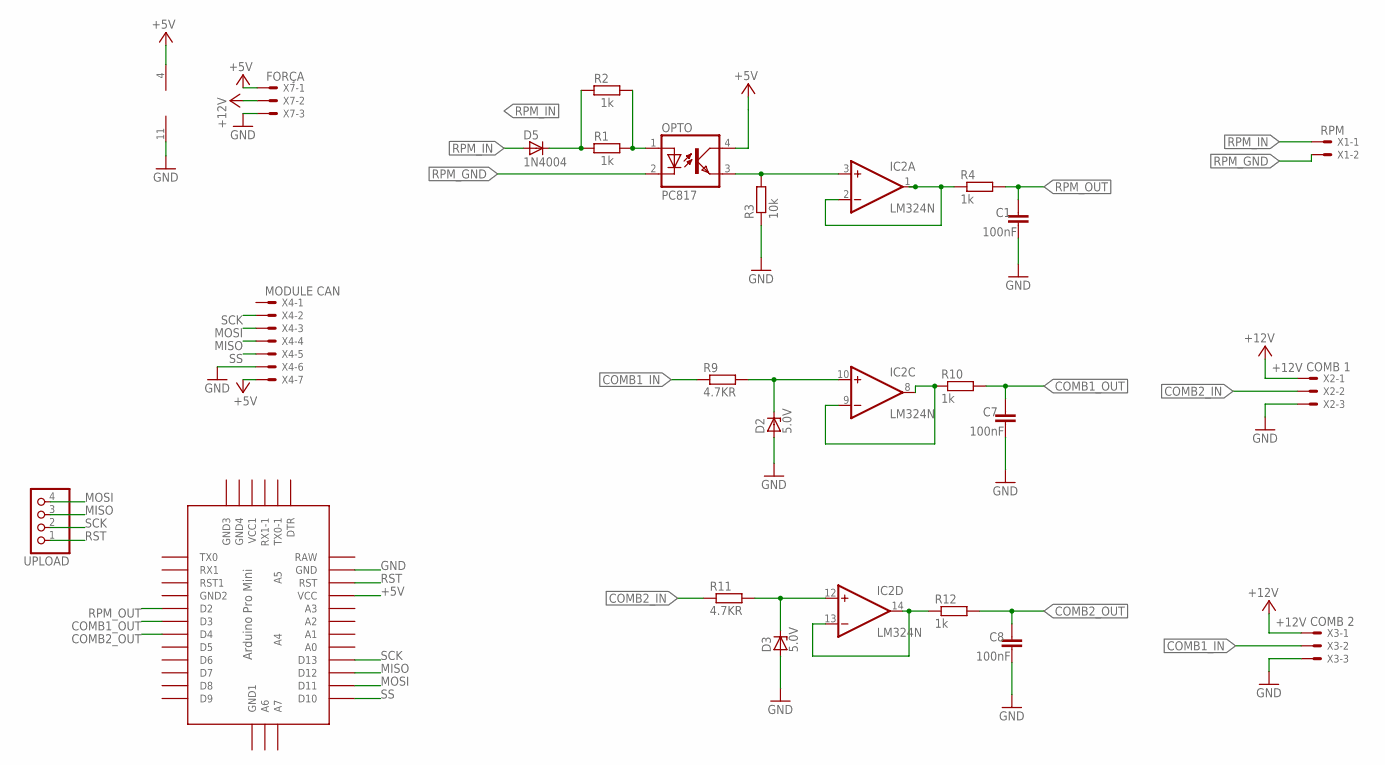
[picture p67: schematic ecu1.sch]

Parts:
C1, C7, C8: 100nF; C5B2.5
D2, D3: 5.0V; DO34Z7
D5: 1N4004; DO41-10
IC2: LM324N; DIL14
OPTO: PC817; DIL04
R1, R2, R4, R10, R12: 1k; 0207/7
R3: 10k; 0207/7
R9, R11: 4.7KR; 0207/7
U$1: ABK-PRO-MINI
UPLOAD: PINHD-1X4; 1X04
X1: RPM; 22-23-2021
X2: COMB 1; 22-23-2031
X3: COMB 2; 22-23-2031
X4: MODULE CAN; 22-23-2071
X7: FORÇA; 22-23-2031

Connections:
+5V: IC2.4 (V+), OPTO.4 (COL), U$1.VCC, X4.7, X7.1
+12V: X2.1, X3.1, X7.2
COMB1_IN: R9.1, X3.2
COMB1_OUT: C7.2, R10.2, U$1.D3
COMB2_IN: R11.1, X2.2
COMB2_OUT: C8.2, R12.2, U$1.D4
GND: C1.1, C7.1, C8.1, D2.A, D3.A, IC2.11 (V-), R3.1, U$1.GND, X2.3, X3.3, X4.6, X7.3
MISO: U$1.D12, UPLOAD.3, X4.4
MOSI: U$1.D11, UPLOAD.4, X4.3
unnamed: OPTO.1 (A), R1.2, R2.2
unnamed: D5.C, R1.1, R2.1
unnamed: IC2.1 (OUT), IC2.2 (-IN), R4.1
unnamed: D2.C, IC2.10 (+IN), R9.2
unnamed: IC2.3 (+IN), OPTO.3 (EMIT), R3.2
unnamed: IC2.8 (OUT), IC2.9 (-IN), R10.1
unnamed: D3.C, IC2.12 (+IN), R11.2
unnamed: IC2.13 (-IN), IC2.14 (OUT), R12.1
RPM_GND: OPTO.2 (C), X1.2
RPM_IN: D5.A, X1.1
RPM_OUT: C1.2, R4.2, U$1.D2
RST: U$1.RST, UPLOAD.1
SCK: U$1.D13, UPLOAD.2, X4.2
SS: U$1.D10, X4.5

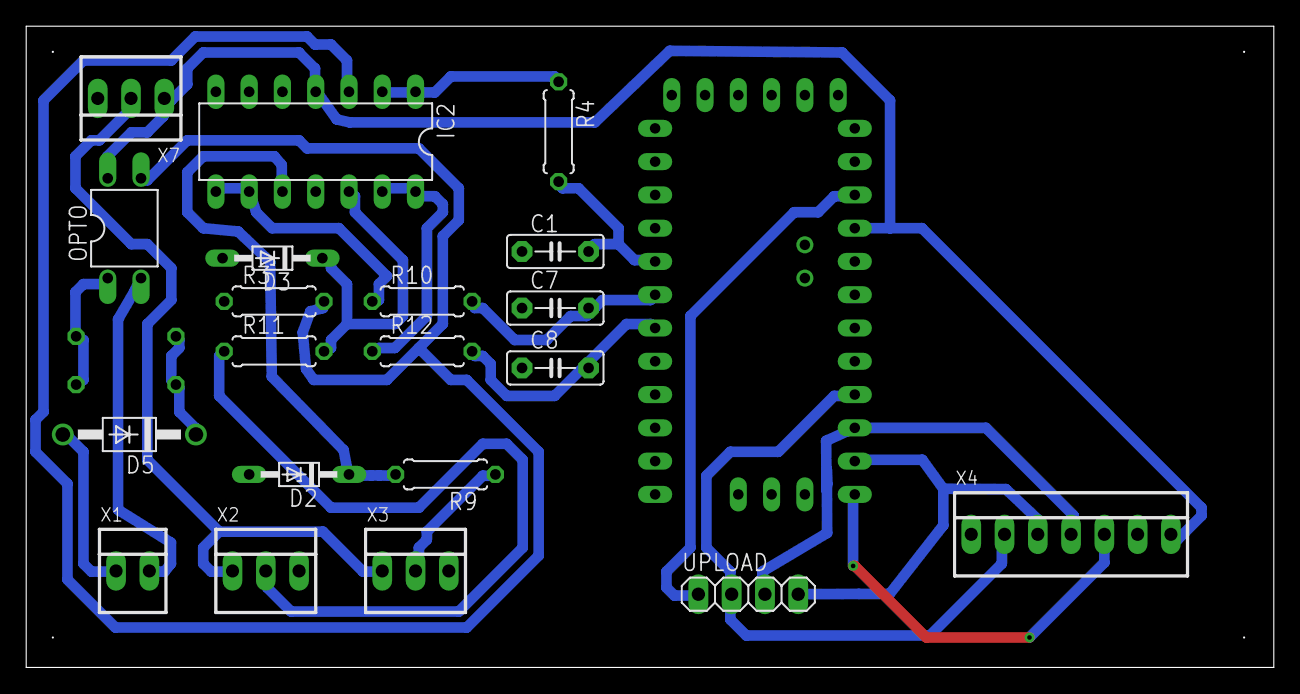
[picture p68: board ecu1.brd from above]

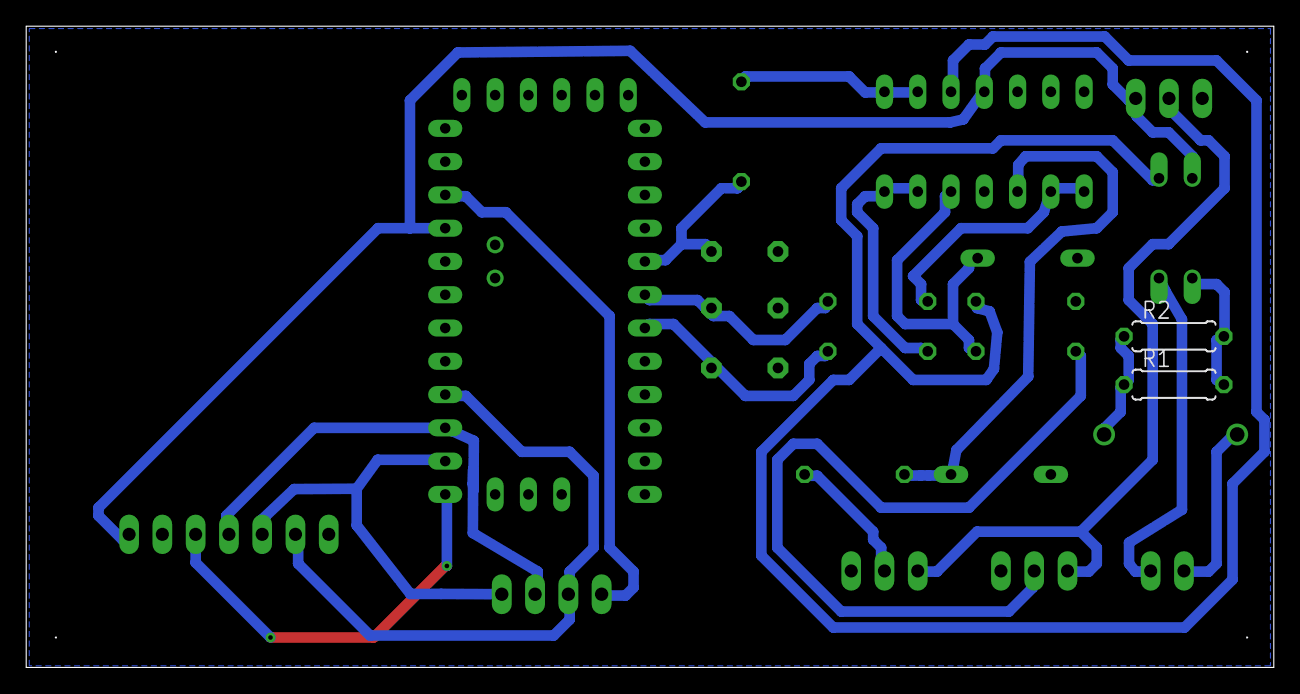
[picture p69: board ecu1.brd from below]

Board: 2 copper layers, 95.2 x 48.9 mm, 23 parts (2 on the bottom side), 23 nets.
