torrematheus/ParahyBaja/PB01 - Hardware/HW06 - Placa de teste AV 2.0/Schematic/placa_teste_av.brd

## EAGLE design PB01 - Hardware/HW06 - Placa de teste AV 2.0/Schematic/placa_teste_av.brd (2019-11-07)

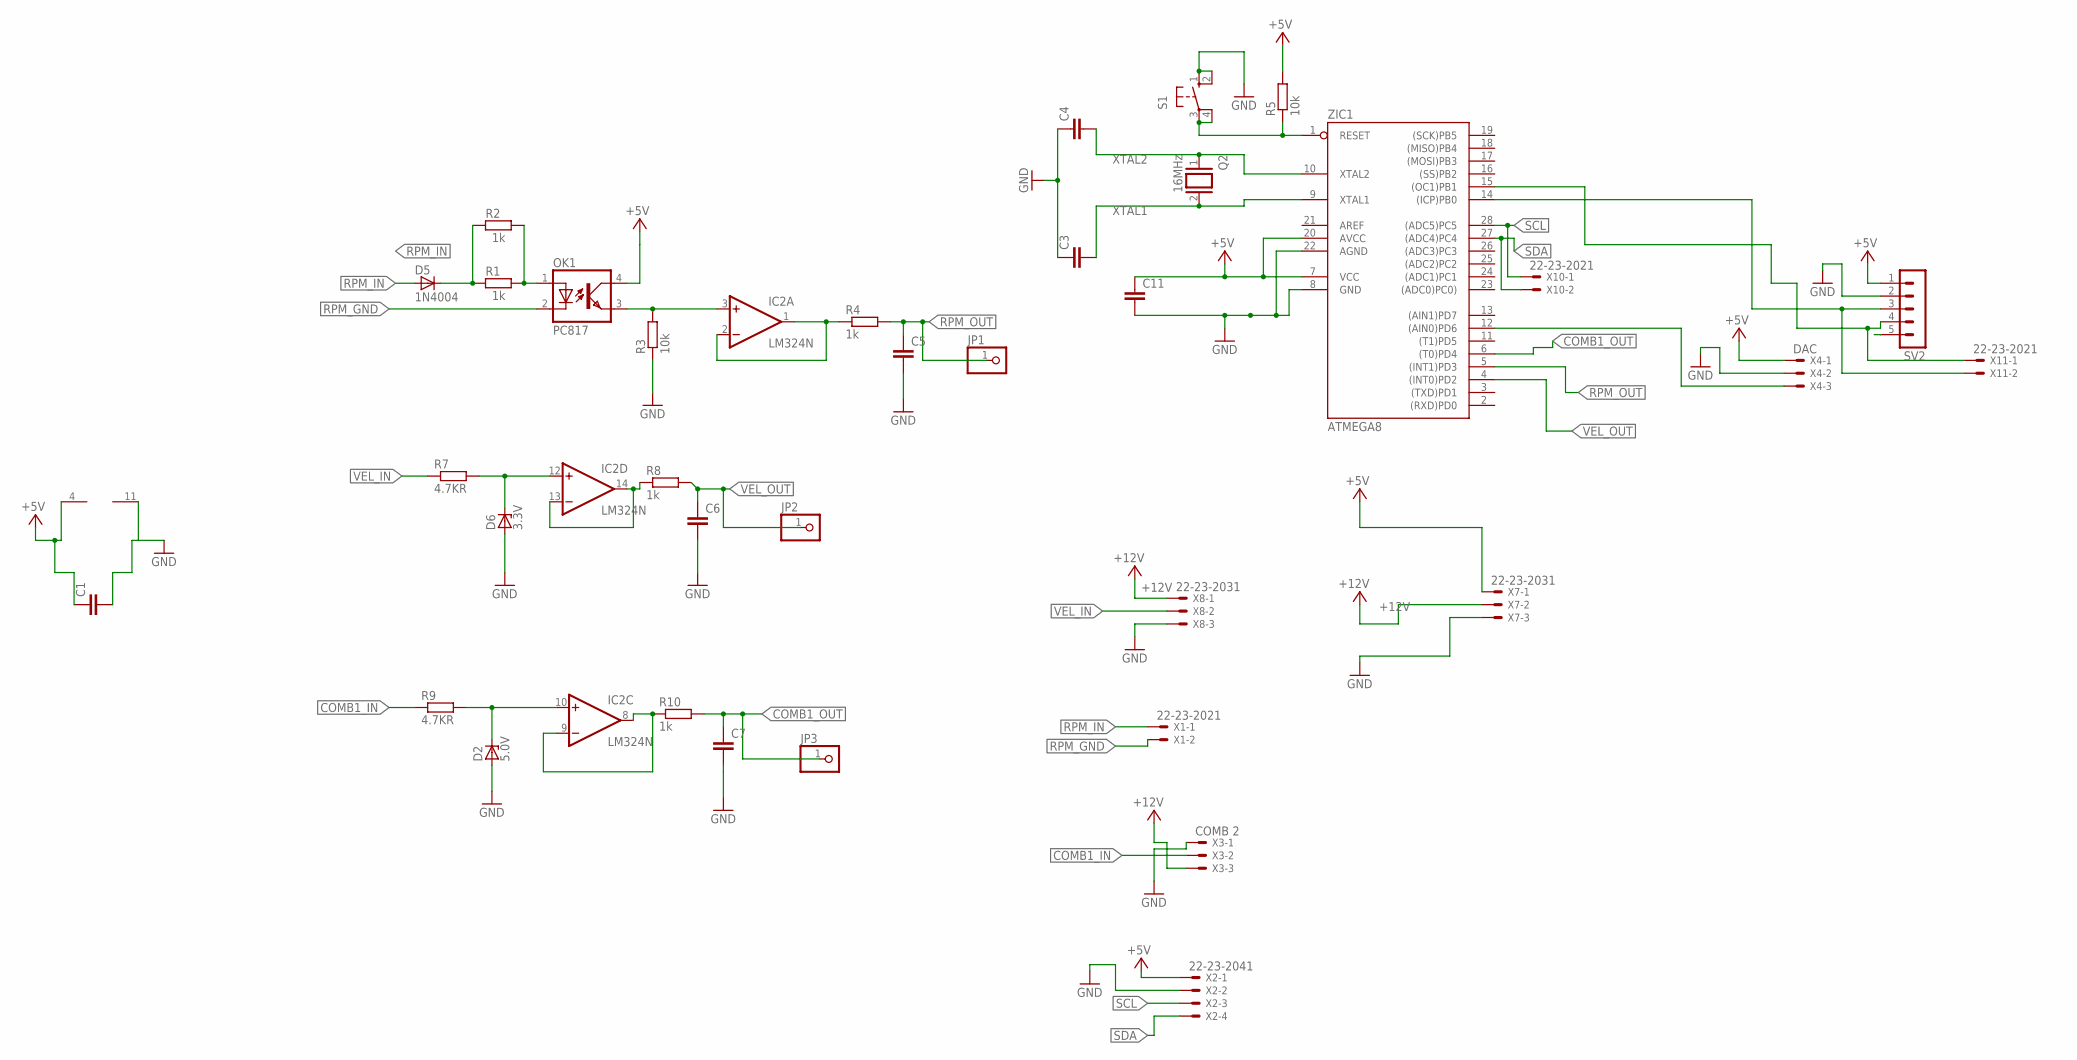
[picture p70: schematic placa_teste_av.sch]

Parts:
C1, C5, C6, C7, C11: C5/2.5; C5B2.5
C3, C4: C-EU025-024X044; C025-024X044
D2: 5.0V; DO34Z7
D5: 1N4004; DO41-10
D6: 3.3V; DO34Z7
IC2: LM324N; DIL14
JP1, JP2, JP3: PINHD-1X1; 1X01
OK1: PC817; DIL04
Q2: 16MHz; QS
R1, R2, R4, R8, R10: 1k; 0207/7
R3, R5: 10k; 0207/7
R7, R9: 4.7KR; 0207/7
S1: 10-XX; B3F-10XX
SV2: MA05-1
X1, X10, X11: 22-23-2021
X2: 22-23-2041
X3: COMB 2; 22-23-2031
X4: DAC; 22-23-2031
X7, X8: 22-23-2031
ZIC1: ATMEGA8; DIL28-3

Connections:
+5V: C1.1, C11.1, IC2.4 (V+), OK1.4 (COL), R5.2, SV2.1, X2.1, X4.1, X7.1, ZIC1.7 (VCC), ZIC1.20 (AVCC)
+12V: X3.3, X7.2, X8.1
COMB1_IN: R9.1, X3.2
COMB1_OUT: C7.1, JP3.1, R10.2, ZIC1.6 ((T0)PD4)
GND: C1.2, C3.1, C4.1, C5.2, C6.2, C7.2, C11.2, D2.A, D6.A, IC2.11 (V-), R3.1, S1.1 (S), S1.2 (S1), SV2.2, X2.2, X3.1, X4.2, X7.3, X8.3, ZIC1.8 (GND), ZIC1.22 (AGND)
IO1: SV2.3, X11.2, ZIC1.14 ((ICP)PB0)
IO2: SV2.4, X11.1, ZIC1.15 ((OC1)PB1)
unnamed: OK1.1 (A), R1.2, R2.2
unnamed: D5.C, R1.1, R2.1
unnamed: IC2.1 (OUT), IC2.2 (-IN), R4.1
unnamed: D2.C, IC2.10 (+IN), R9.2
unnamed: IC2.3 (+IN), OK1.3 (EMIT), R3.2
unnamed: D6.C, IC2.12 (+IN), R7.2
unnamed: R5.1, S1.3, S1.4 (P1), ZIC1.1 (RESET)
unnamed: X4.3, ZIC1.12 ((AIN0)PD6)
unnamed: IC2.8 (OUT), IC2.9 (-IN), R10.1
PA10: IC2.13 (-IN), IC2.14 (OUT), R8.1
RPM_GND: OK1.2 (C), X1.2
RPM_IN: D5.A, X1.1
RPM_OUT: C5.1, JP1.1, R4.2, ZIC1.5 ((INT1)PD3)
SCL: X2.3, X10.1, ZIC1.28 ((ADC5)PC5)
SDA: X2.4, X10.2, ZIC1.27 ((ADC4)PC4)
VEL_IN: R7.1, X8.2
VEL_OUT: C6.1, JP2.1, R8.2, ZIC1.4 ((INT0)PD2)
XTAL1: C3.2, Q2.2, ZIC1.9 (XTAL1)
XTAL2: C4.2, Q2.1, ZIC1.10 (XTAL2)

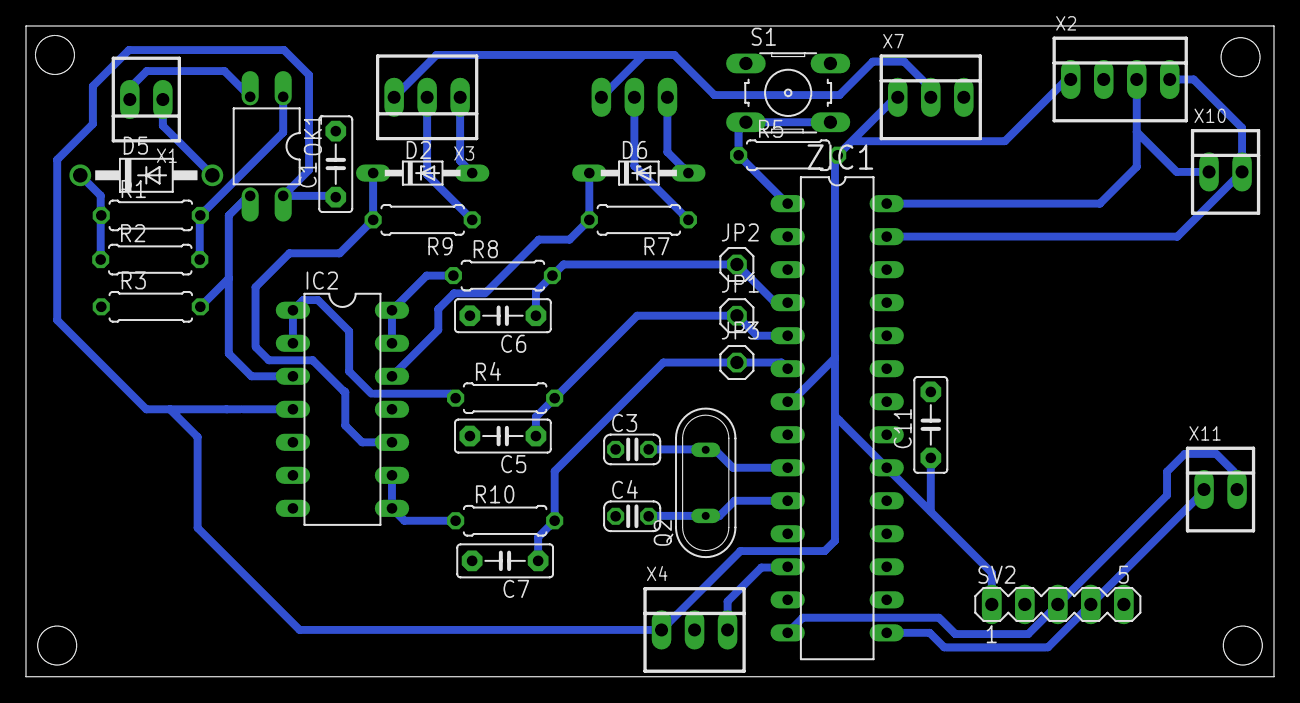
[picture p71: board placa_teste_av.brd from above]

Board: 2 copper layers, 96.0 x 50.1 mm, 36 parts (1 on the bottom side), 26 nets.
