torrematheus/ParahyBaja/PB01 - Hardware/HW04 - Placa de ECU2 Telemetria/ecu2_telemetria.brd

## EAGLE design PB01 - Hardware/HW04 - Placa de ECU2 Telemetria/ecu2_telemetria.brd (2019-11-07)

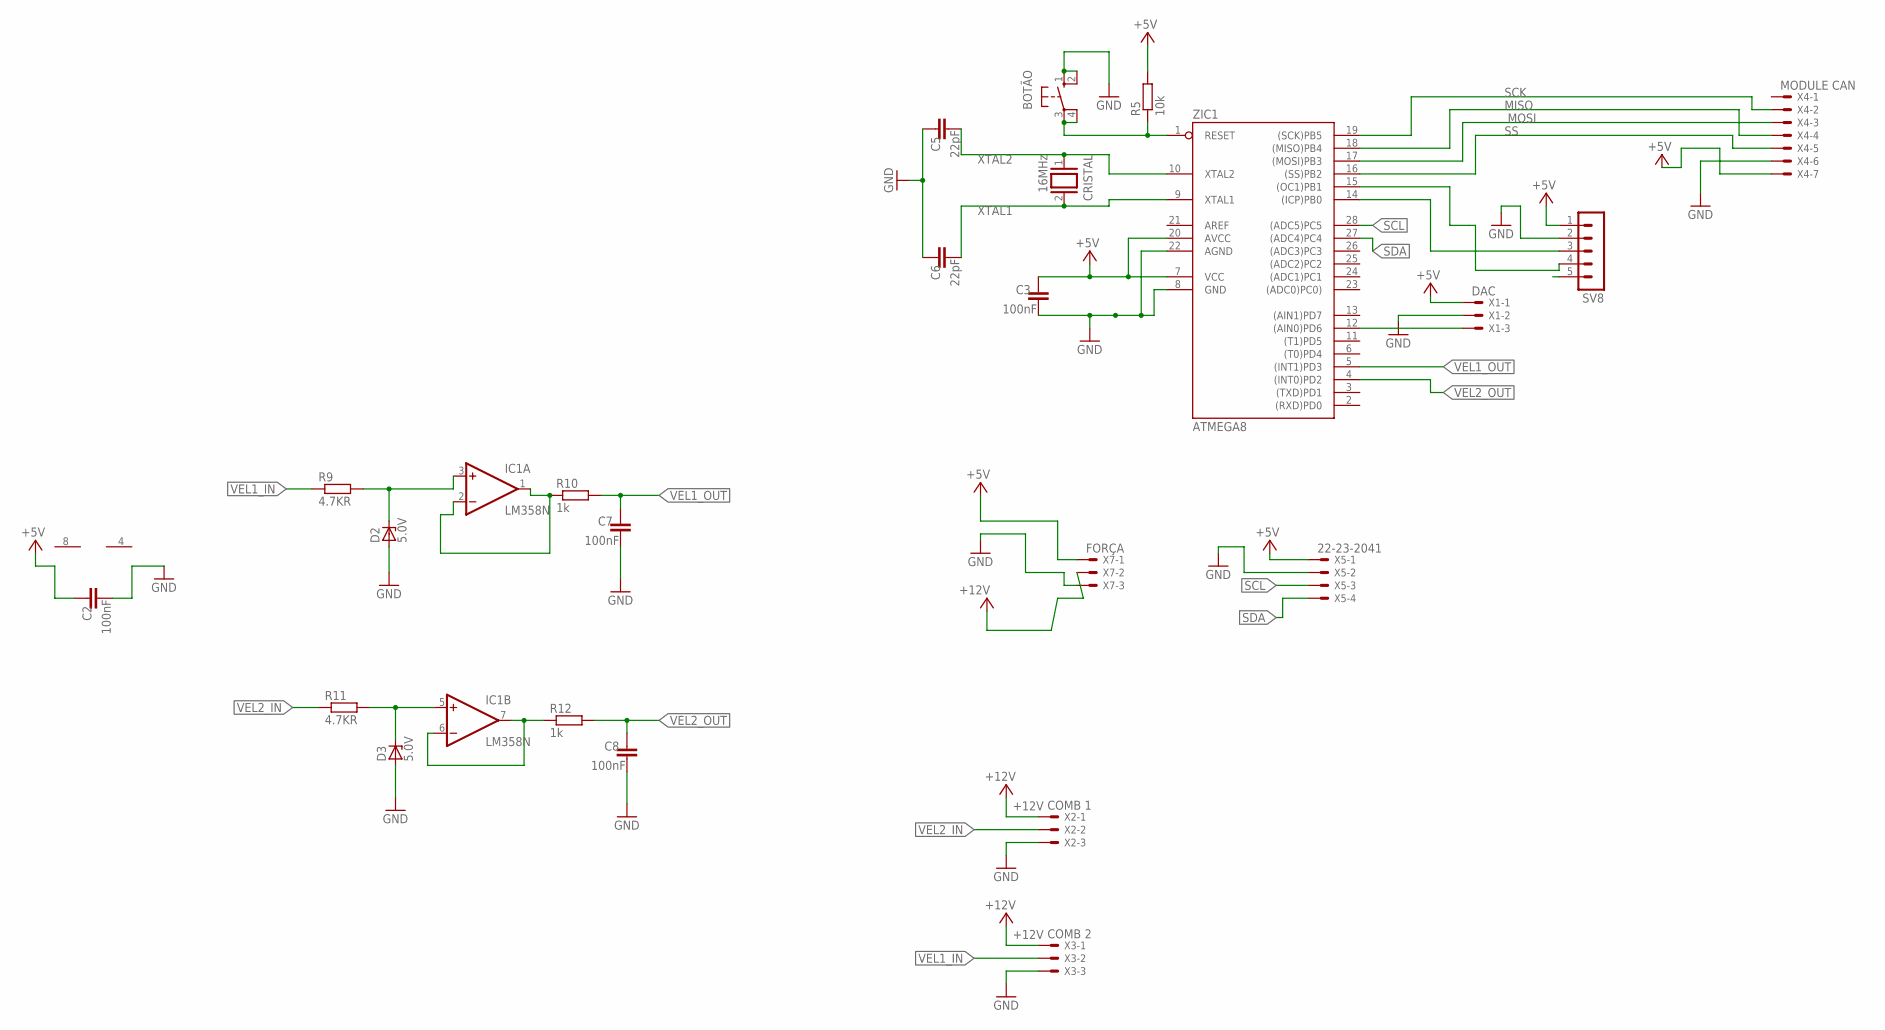
[picture p72: schematic ecu2_telemetria.sch]

Parts:
BOTÃO: 10-XX; B3F-10XX
C2, C3, C7, C8: 100nF; C5B2.5
C5, C6: 22pF; C5B2.5
CRISTAL: 16MHz; QS
D2, D3: 5.0V; DO34Z7
IC1: LM358N; DIL08
R5: 10k; 0207/7
R9, R11: 4.7KR; 0207/7
R10, R12: 1k; 0207/7
SV8: MA05-1
X1: DAC; 22-23-2031
X2: COMB 1; 22-23-2031
X3: COMB 2; 22-23-2031
X4: MODULE CAN; 22-23-2071
X5: 22-23-2041
X7: FORÇA; 22-23-2031
ZIC1: ATMEGA8; DIL28-3

Connections:
+5V: C2.2, C3.2, R5.2, SV8.1, X1.1, X4.7, X5.1, X7.1, ZIC1.7 (VCC), ZIC1.20 (AVCC)
+12V: X2.1, X3.1, X7.2
GND: BOTÃO.1 (S), BOTÃO.2 (S1), C2.1, C3.1, C5.2, C6.2, C7.1, C8.1, D2.A, D3.A, SV8.2, X1.2, X2.3, X3.3, X4.6, X5.2, X7.3, ZIC1.8 (GND), ZIC1.22 (AGND)
IO8: SV8.3, ZIC1.14 ((ICP)PB0)
IO9: SV8.4, ZIC1.15 ((OC1)PB1)
MISO: X4.4, ZIC1.18 ((MISO)PB4)
MOSI: X4.3, ZIC1.17 ((MOSI)PB3)
unnamed: X1.3, ZIC1.12 ((AIN0)PD6)
unnamed: D2.C, IC1.3 (+IN), R9.2
unnamed: BOTÃO.3, BOTÃO.4 (P1), R5.1, ZIC1.1 (RESET)
unnamed: IC1.1 (OUT), IC1.2 (-IN), R10.1
unnamed: D3.C, IC1.5 (+IN), R11.2
unnamed: IC1.6 (-IN), IC1.7 (OUT), R12.1
SCK: X4.2, ZIC1.19 ((SCK)PB5)
SCL: X5.3, ZIC1.28 ((ADC5)PC5)
SDA: X5.4, ZIC1.27 ((ADC4)PC4)
SS: X4.5, ZIC1.16 ((SS)PB2)
V+: IC1.8 (V+)
V-: IC1.4 (V-)
VEL1_IN: R9.1, X3.2
VEL1_OUT: C7.2, R10.2, ZIC1.5 ((INT1)PD3)
VEL2_IN: R11.1, X2.2
VEL2_OUT: C8.2, R12.2, ZIC1.4 ((INT0)PD2)
XTAL1: C6.1, CRISTAL.2, ZIC1.9 (XTAL1)
XTAL2: C5.1, CRISTAL.1, ZIC1.10 (XTAL2)

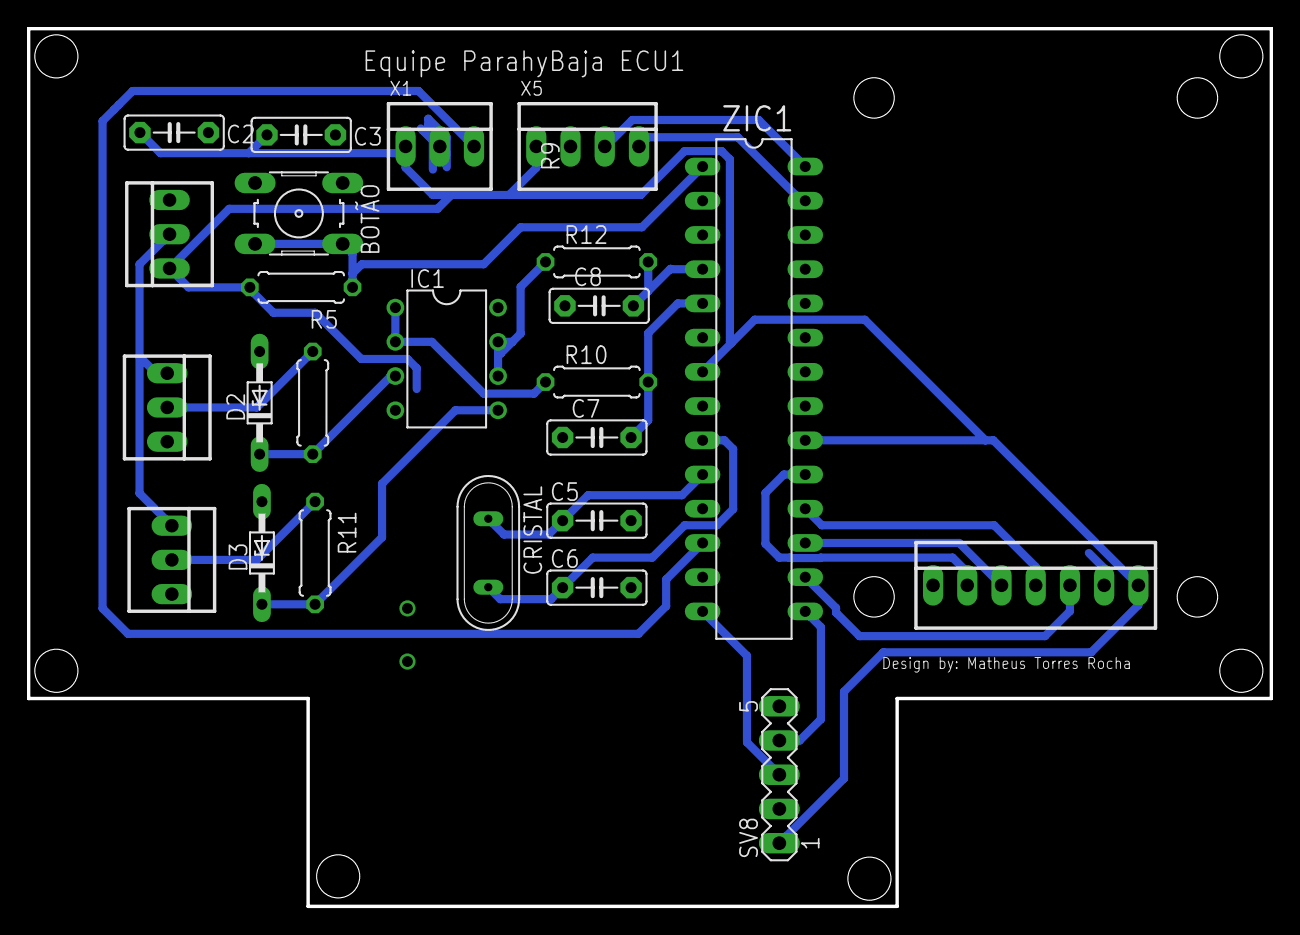
[picture p73: board ecu2_telemetria.brd from above]

Board: 2 copper layers, 92.2 x 65.2 mm, 24 parts (0 on the bottom side), 23 nets.
