torrematheus/ParahyBaja/PB01 - Hardware/HW05 - Placa LEDs para RPM/Placa_LEDs/PlacaLEDS/PlacaLEDS.brd

## EAGLE design PB01 - Hardware/HW05 - Placa LEDs para RPM/Placa_LEDs/PlacaLEDS/PlacaLEDS.brd (2019-11-07)

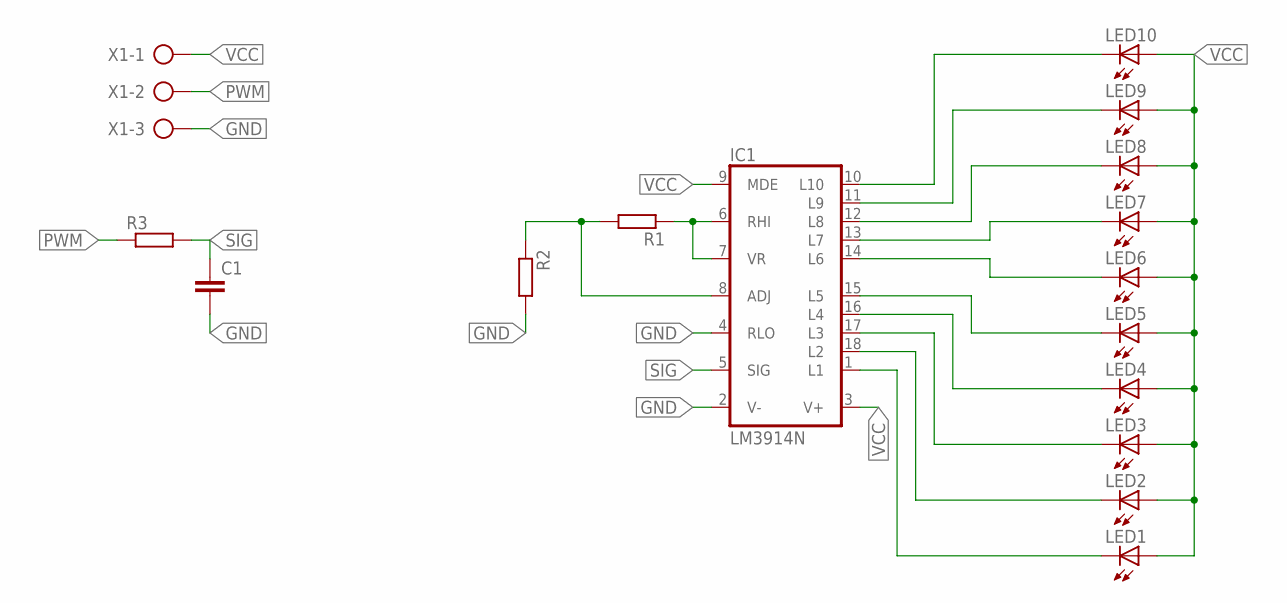
[picture p74: schematic PlacaLEDS.sch]

Parts:
C1: C-EU025-050X050; C025-050X050
IC1: LM3914N; DIL18
LED1, LED2, LED3, LED4, LED5, LED6, LED7, LED8, LED9, LED10: LED5MM
R1, R2, R3: R-EU_0204/7; 0204/7
X1: AK500/3

Connections:
GND: C1.2, IC1.2 (V-), IC1.4 (RLO), R2.2, X1.3
unnamed: IC1.10 (L10), LED10.K (C)
unnamed: IC1.11 (L9), LED9.K (C)
unnamed: IC1.12 (L8), LED8.K (C)
unnamed: IC1.13 (L7), LED7.K (C)
unnamed: IC1.14 (L6), LED6.K (C)
unnamed: IC1.15 (L5), LED5.K (C)
unnamed: IC1.16 (L4), LED4.K (C)
unnamed: IC1.17 (L3), LED3.K (C)
unnamed: IC1.18 (L2), LED2.K (C)
unnamed: IC1.1 (L1), LED1.K (C)
unnamed: IC1.6 (RHI), IC1.7 (VR), R1.1
unnamed: IC1.8 (ADJ), R1.2, R2.1
PWM: R3.1, X1.2
SIG: C1.1, IC1.5 (SIG), R3.2
VCC: IC1.3 (V+), IC1.9 (MDE), LED1.A, LED2.A, LED3.A, LED4.A, LED5.A, LED6.A, LED7.A, LED8.A, LED9.A, LED10.A, X1.1

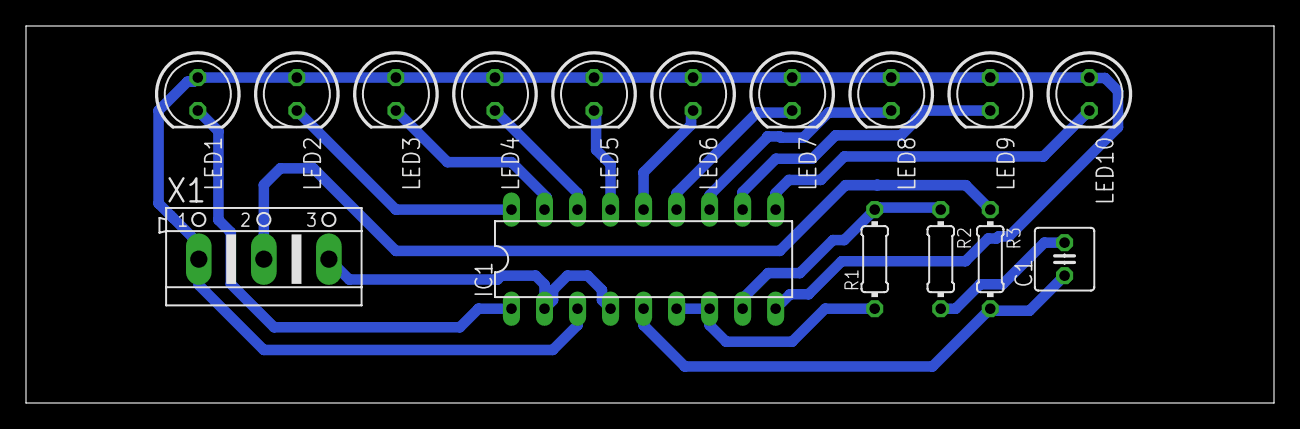
[picture p75: board PlacaLEDS.brd from above]

Board: 2 copper layers, 96.0 x 29.0 mm, 16 parts (0 on the bottom side), 16 nets.
