torrematheus/ParahyBaja/PB01 - Hardware/HW04 - Placa de ECU2 Telemetria/ecu1_telemetria.brd

## EAGLE design PB01 - Hardware/HW04 - Placa de ECU2 Telemetria/ecu1_telemetria.brd (2019-09-19)

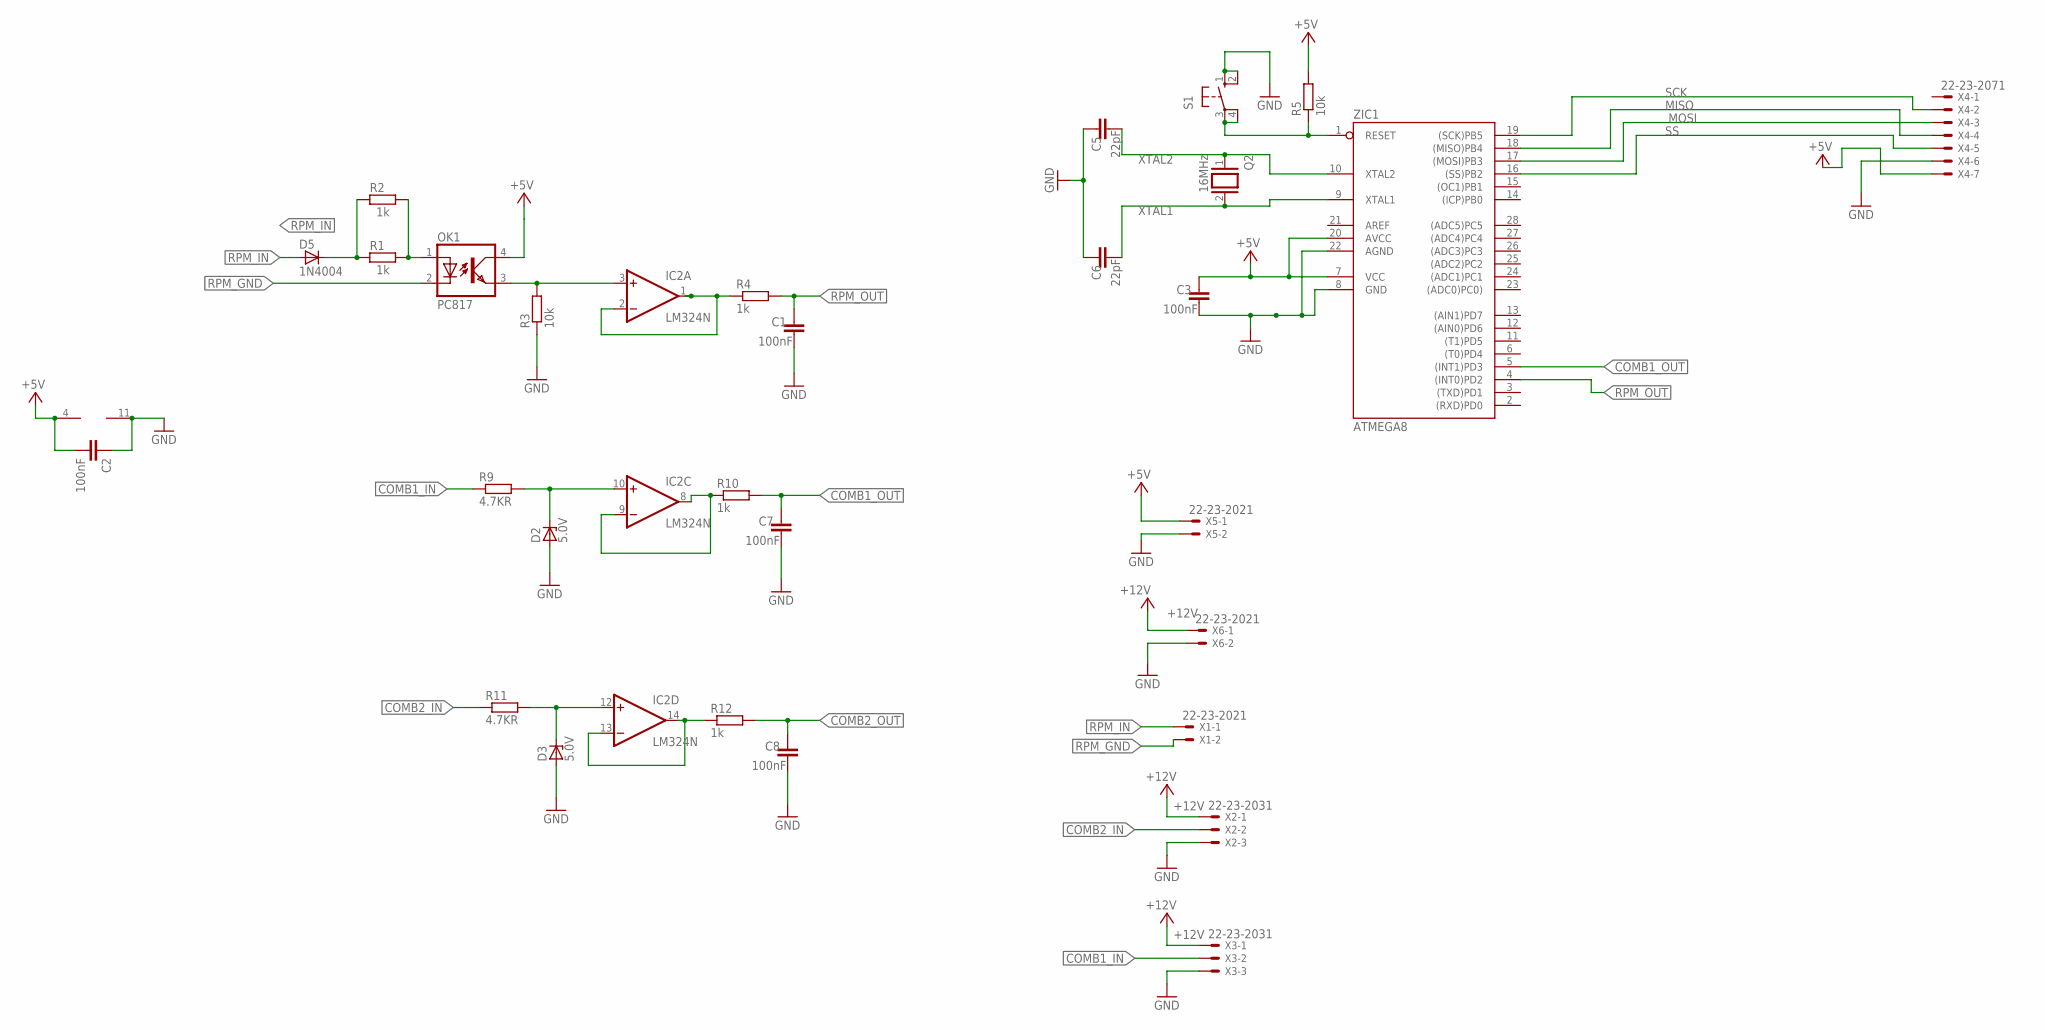
[picture p76: schematic ecu1_telemetria.sch]

Parts:
C1, C3, C7, C8: 100nF; C5B2.5
C2: 100nF; C2.5-3
C5, C6: 22pF; C5B2.5
D2, D3: 5.0V; DO34Z7
D5: 1N4004; DO41-10
IC2: LM324N; DIL14
OK1: PC817; DIL04
Q2: 16MHz; QS
R1, R2, R4, R10, R12: 1k; 0207/7
R3, R5: 10k; 0207/7
R9, R11: 4.7KR; 0207/7
S1: 10-XX; B3F-10XX
X1, X5, X6: 22-23-2021
X2, X3: 22-23-2031
X4: 22-23-2071
ZIC1: ATMEGA8; DIL28-3

Connections:
+5V: C2.2, C3.2, IC2.4 (V+), OK1.4 (COL), R5.2, X4.7, X5.1, ZIC1.7 (VCC), ZIC1.20 (AVCC)
+12V: X2.1, X3.1, X6.1
COMB1_IN: R9.1, X3.2
COMB1_OUT: C7.2, R10.2, ZIC1.5 ((INT1)PD3)
COMB2_IN: R11.1, X2.2
COMB2_OUT: C8.2, R12.2
GND: C1.1, C2.1, C3.1, C5.2, C6.2, C7.1, C8.1, D2.A, D3.A, IC2.11 (V-), R3.1, S1.1 (S), S1.2 (S1), X2.3, X3.3, X4.6, X5.2, X6.2, ZIC1.8 (GND), ZIC1.22 (AGND)
MISO: X4.4, ZIC1.18 ((MISO)PB4)
MOSI: X4.3, ZIC1.17 ((MOSI)PB3)
unnamed: OK1.1 (A), R1.2, R2.2
unnamed: D5.C, R1.1, R2.1
unnamed: IC2.1 (OUT), IC2.2 (-IN), R4.1
unnamed: D2.C, IC2.10 (+IN), R9.2
unnamed: IC2.3 (+IN), OK1.3 (EMIT), R3.2
unnamed: R5.1, S1.3, S1.4 (P1), ZIC1.1 (RESET)
unnamed: IC2.8 (OUT), IC2.9 (-IN), R10.1
unnamed: D3.C, IC2.12 (+IN), R11.2
unnamed: IC2.13 (-IN), IC2.14 (OUT), R12.1
RPM_GND: OK1.2 (C), X1.2
RPM_IN: D5.A, X1.1
RPM_OUT: C1.2, R4.2, ZIC1.4 ((INT0)PD2)
SCK: X4.2, ZIC1.19 ((SCK)PB5)
SS: X4.5, ZIC1.16 ((SS)PB2)
XTAL1: C6.1, Q2.2, ZIC1.9 (XTAL1)
XTAL2: C5.1, Q2.1, ZIC1.10 (XTAL2)

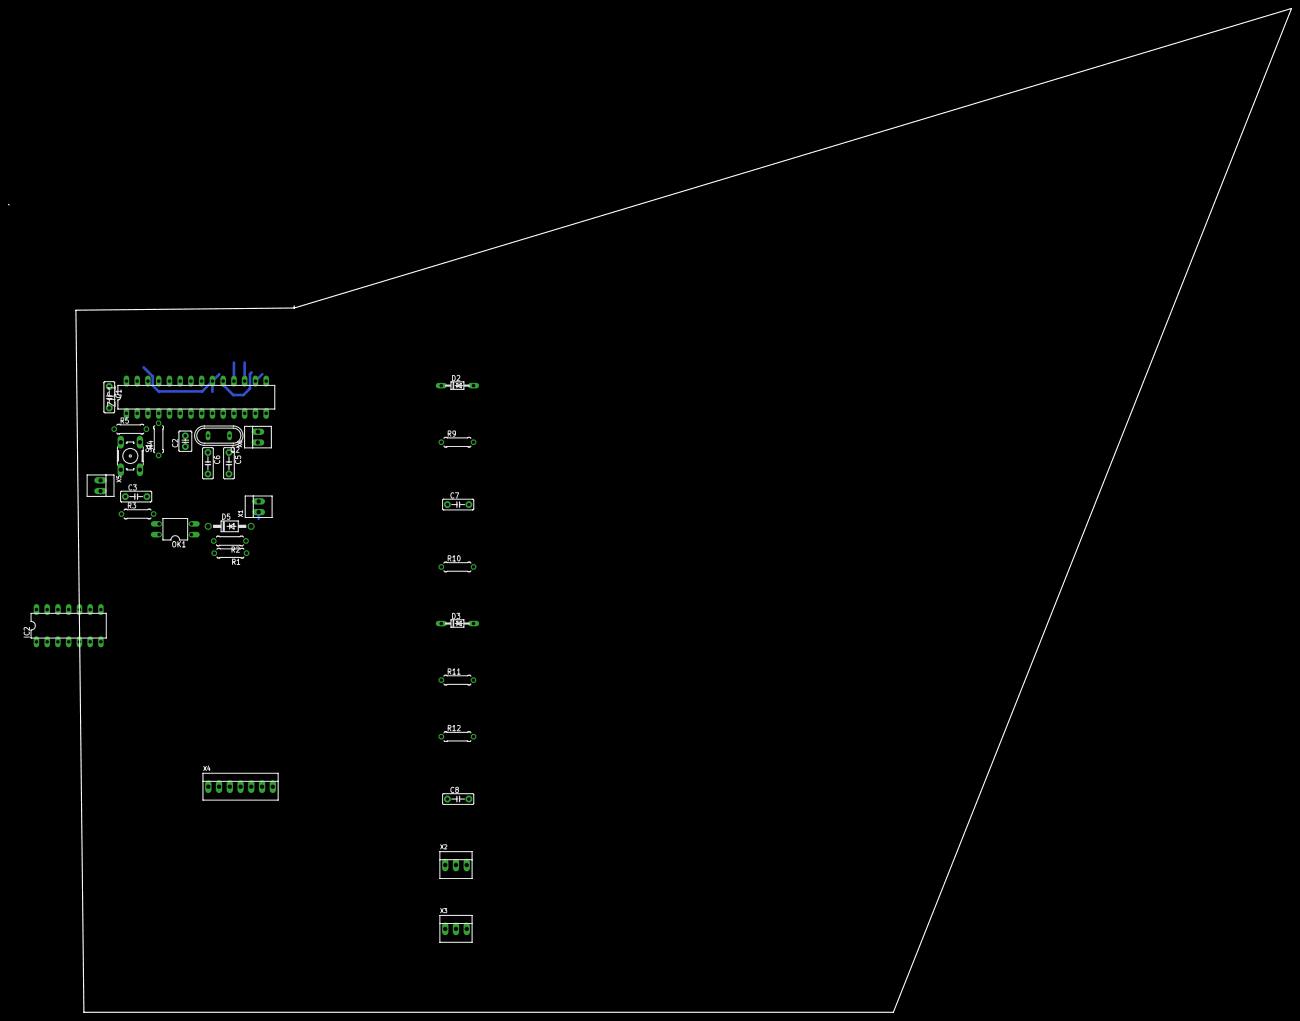
[picture p77: board ecu1_telemetria.brd from above]

Board: 2 copper layers, 303.3 x 237.3 mm, 30 parts (0 on the bottom side), 25 nets.
