torrematheus/ParahyBaja/PB01 - Hardware/HW02 - Placa de teste do Extensometro/extensometro.brd

## EAGLE design PB01 - Hardware/HW02 - Placa de teste do Extensometro/extensometro.brd (2019-08-23)

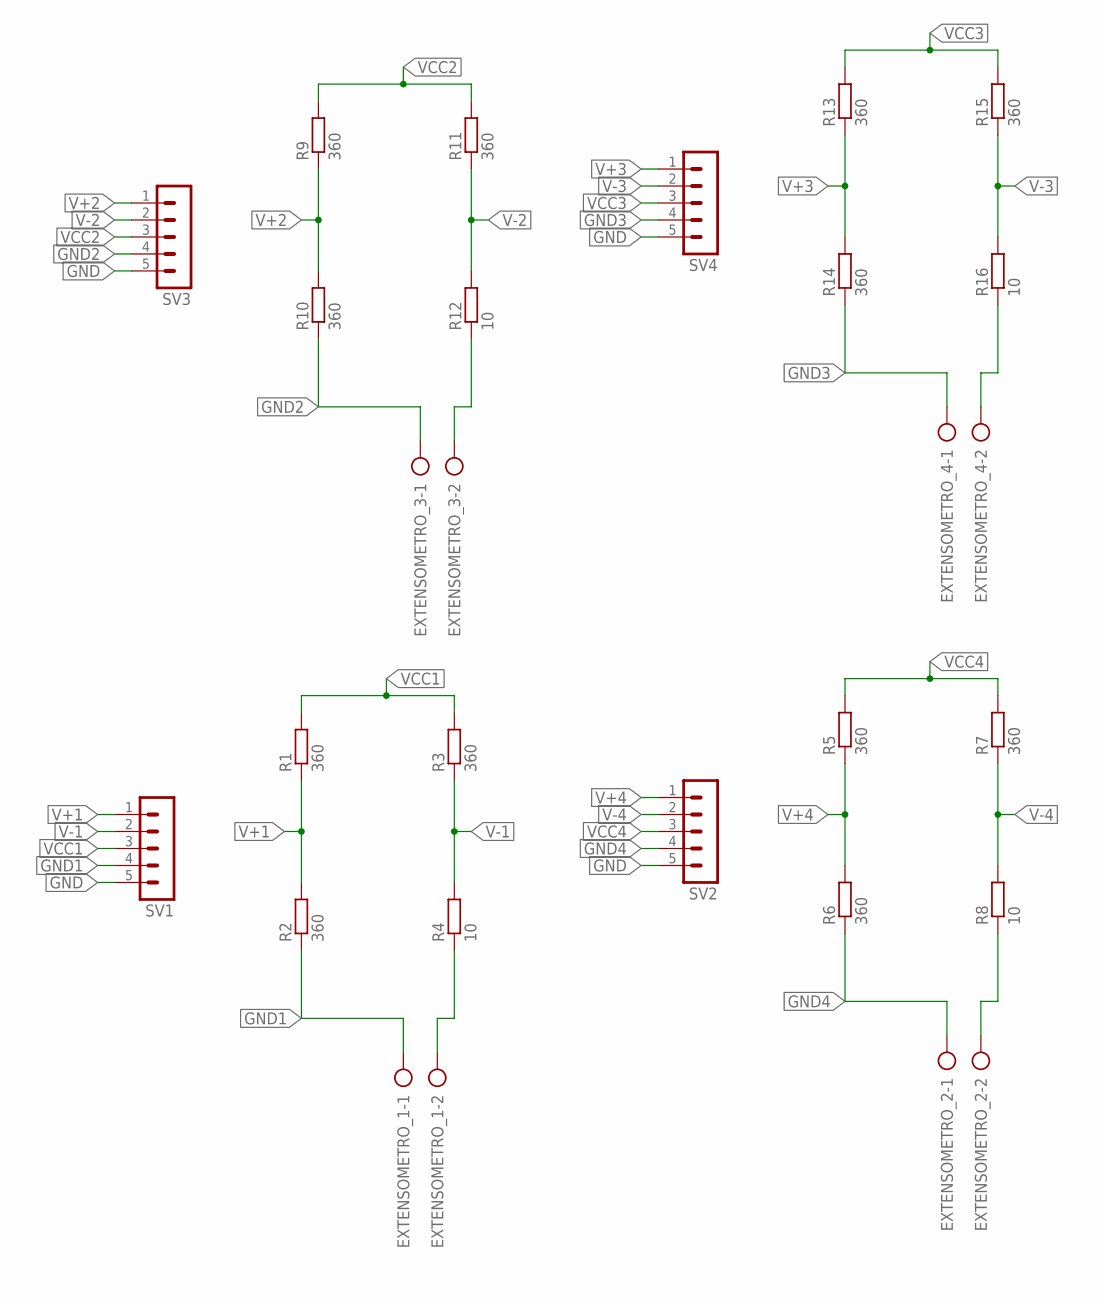
[picture p78: schematic extensometro.sch]

Parts:
EXTENSOMETRO_1, EXTENSOMETRO_2, EXTENSOMETRO_3, EXTENSOMETRO_4: AK500/2
R1, R2, R3, R5, R6, R7, R9, R10, R11, R13, R14, R15: 360; 0207/7
R4, R8, R12, R16: 10; 0207/7
SV1, SV2, SV3, SV4: MA05-1

Connections:
GND: SV1.5, SV2.5, SV3.5, SV4.5
GND1: EXTENSOMETRO_1.1, R2.1, SV1.4
GND2: EXTENSOMETRO_3.1, R10.1, SV3.4
GND3: EXTENSOMETRO_4.1, R14.1, SV4.4
GND4: EXTENSOMETRO_2.1, R6.1, SV2.4
unnamed: EXTENSOMETRO_2.2, R8.1
unnamed: EXTENSOMETRO_1.2, R4.1
unnamed: EXTENSOMETRO_3.2, R12.1
unnamed: EXTENSOMETRO_4.2, R16.1
V+1: R1.1, R2.2, SV1.1
V+2: R9.1, R10.2, SV3.1
V+3: R13.1, R14.2, SV4.1
V+4: R5.1, R6.2, SV2.1
V-1: R3.1, R4.2, SV1.2
V-2: R11.1, R12.2, SV3.2
V-3: R15.1, R16.2, SV4.2
V-4: R7.1, R8.2, SV2.2
VCC1: R1.2, R3.2, SV1.3
VCC2: R9.2, R11.2, SV3.3
VCC3: R13.2, R15.2, SV4.3
VCC4: R5.2, R7.2, SV2.3

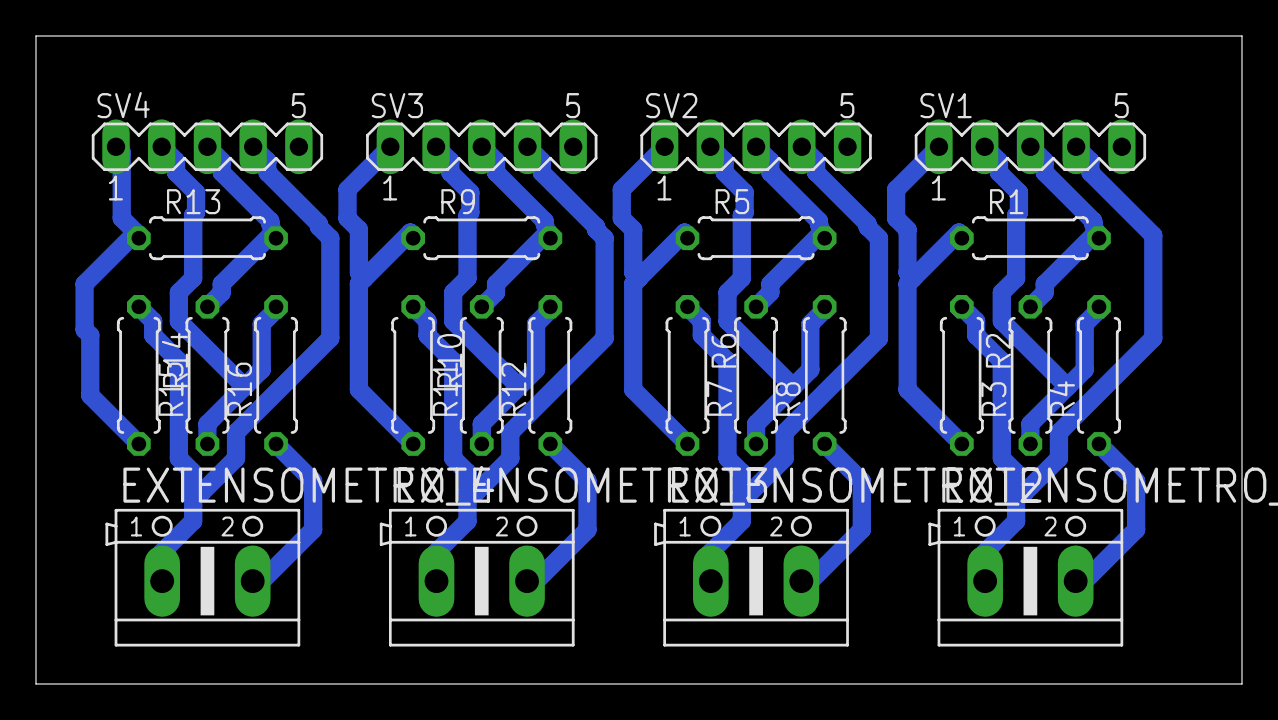
[picture p79: board extensometro.brd from above]

Board: 2 copper layers, 67.0 x 36.0 mm, 24 parts (0 on the bottom side), 21 nets.
