torrematheus/ParahyBaja/(commit log)

2019-08-21 Placa de teste AV
    [simulation_teste_av.pdsprj]
2019-08-21 Teste de AV
    [simulation_teste_av.pdsprj]
2019-08-21 21/08/2019
    Adicionado o TCC de Matheus Torres, ajuste na simulação do teste AV
    [simulation_teste_av.pdsprj]
2019-08-23 Teste do Extensometro
    [extensometro.brd, extensometro.sch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]
2019-09-06 Placa ECU1 da telemetria
    [ecu1_telemetria.brd, ecu1_telemetria.sch]
2019-09-19 ECU 1 e 2 Telemetria
    [ecu1_telemetria.brd, ecu1_telemetria.sch]
2019-10-07 Placa Leds RPM
    [PlacaLEDS.brd, PlacaLEDS.sch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]
2019-10-28 Placa de AV 2.0
    [ecu2_telemetria.brd, ecu2_telemetria.sch, placa_teste_av.brd, placa_teste_av.sch, simulation_teste_av.pdsprj]
2019-10-28 Placa AV 2.0
    [placa_teste_av.drl]
2019-10-28 teste de av 2.0
    [placa_teste_av.brd]
2020-02-20 ECU1 NAC_2020
    [ecu1.brd, ecu1.sch]
